WeActStudio/MiniSTM32H7xx/SDK/QSPI_Flasher/README.md

# QSPI Flasher

## STM32H7xx_W25Qxx_WeActStudio.FLM
> Keil MDK
Support 4MB ~ 16MB W25Qxx Flash

请将文件复制到 `Keil安装目录\ARM\Flash\`

Please copy the file to `"KeilInstallationDirectory"\ARM\Flash`

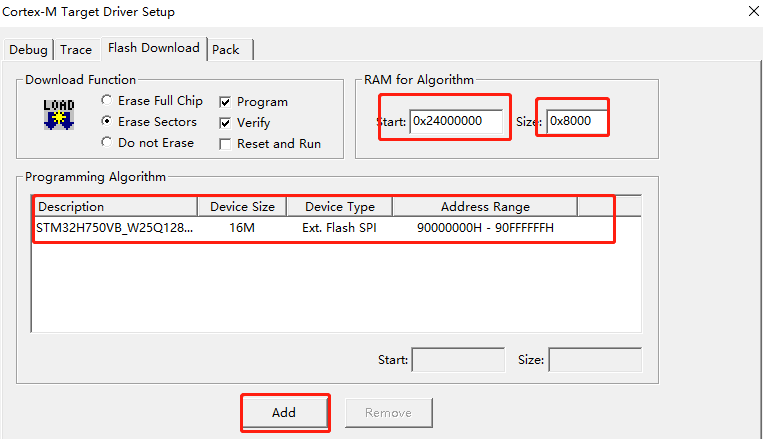
[picture p7: SDK/QSPI_Flasher/Images/KeilSetup.png]


## STM32H7xx_W25Qxx_WeActStudio.stldr
> STM32CubeProgrammer
Support 4MB ~ 16MB W25Qxx Flash

请将文件复制到 `STM32CubeProgrammer安装目录\bin\ExternalLoader\`

Please copy the file to `"STM32CubeProgrammerInstallationDirectory"\bin\ExternalLoader\`

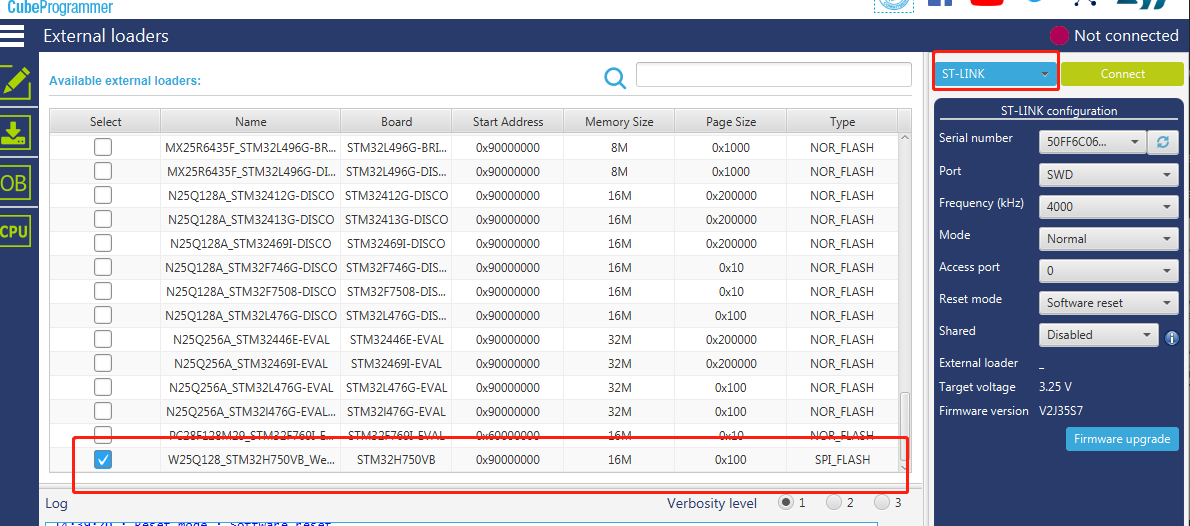
[picture p8: SDK/QSPI_Flasher/Images/STM32CubeProgSetup01.png]


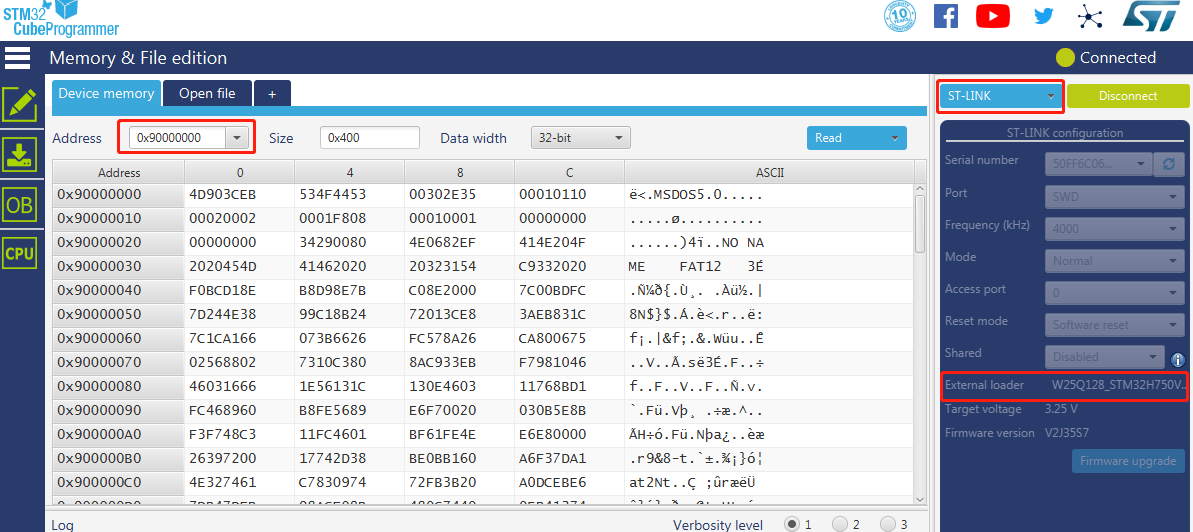
[picture p9: SDK/QSPI_Flasher/Images/STM32CubeProgSetup02.png]
