WeActStudio/MiniSTM32H7xx/SDK/HAL/STM32H743/05-DCMI_UVC/README.md

# WeAct Studio
## DCMI UVC Test

DCMI UVC测试，模拟USB摄像头，分辨率为160x120,帧率约为14FPS
* 支持OV2640,OV7670

DCMI UVC test, analog USB camera, 160x120 resolution, frame rate is about 14FPS
* Support for OV2640,OV7670
