WeActStudio/MiniSTM32H7xx/SDK/HAL/STM32H743/01-GPIO/README.md

# WeAct Studio
## GPIO Test

使用RNG随机数发生器生成随机数控制LED`PE3`随机闪烁

RNG random number generator is used to generate random Numbers to control LED `PE3` random flicker
