WeActStudio/MiniSTM32H7xx/SDK/openmv/Example/Below V4.4.1/track_color/README.md

# 使用说明

* [English](./README_EN.md)

当前例程为跟踪圆形的例程，可以使用下面的图片进行测试

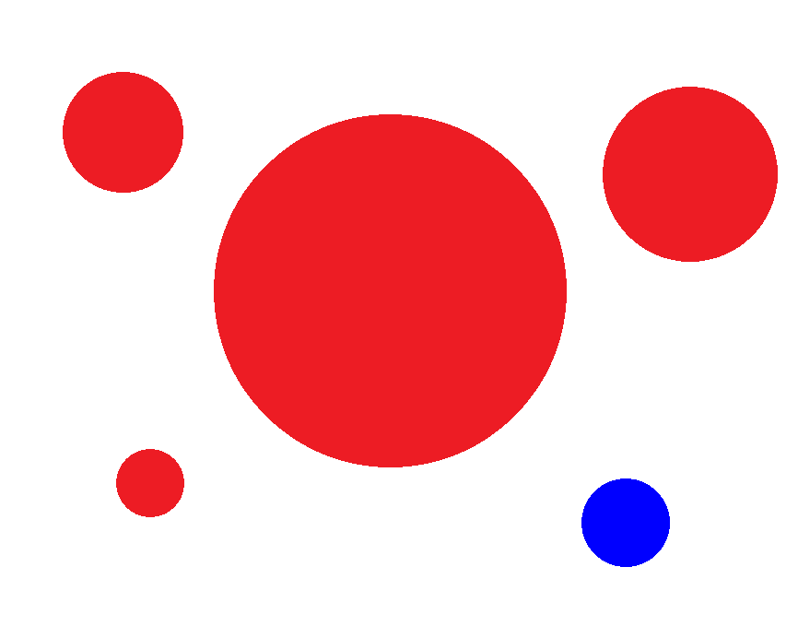
[picture p13: SDK/openmv/Example/Below V4.4.1/track_color/track_circle.png]
first


如果使用的是0v7725 请将下面两行代码反注释

``` c
sensor.set_hmirror(True)
sensor.set_vflip(True)
```

不同环境对应阈值也不同请根据你所在环境的阈值进行调整，也就是下面红绿蓝三个阈值

``` c
red_threshold = (53, 31, 44, 82, 18, 78)
```

对应IDE相应操作为：工具->机器视觉->阈值编辑器->帧缓冲区
