WeActStudio/MiniSTM32H7xx/SDK/HAL/STM32H743/02-ExtMem_Boot/README.md

# WeAct Studio
## ExtMem Boot

在8MB QSPI Flash上运行程序，该例程为QSPI Bootloader,APP Addr: `0x90000000`

Run the program on 8MB QSPI Flash, this routine is QSPI Bootloader,APP Addr: `0x90000000`
