WeActStudio/MiniSTM32H7xx/Images/Flash Delay.png

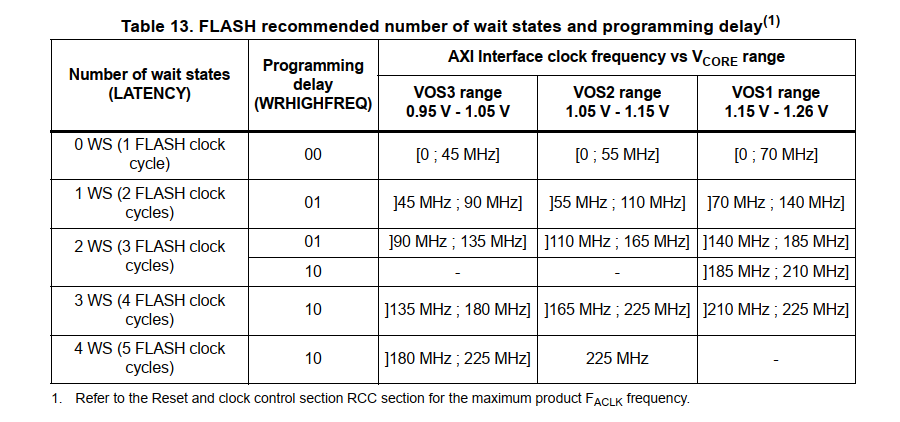
Images/Flash Delay.png
