WeActStudio/MiniSTM32H7xx/SDK/HAL/STM32H743/06-SPIFlash_Test/README.md

# WeAct Studio
## SPI Flash Test

两颗Flash读写测试，通过USB模拟成两个U盘

Two Flash read and write tests, through USB simulation into two U disk
