WeActStudio/MiniSTM32H7xx/SDK/HAL/STM32H743/07-ADC_Test/README.md

# WeAct Studio
## ADC Test

ADC 测试，通过ADC读取Vrefint,温度,vbat

ADC test, read Vrefint, temperature,vbat by ADC
