WeActStudio/MiniSTM32H7xx/SDK/HAL/STM32H743/09-PWR_Test/README.md

# WeAct Studio
## PWR Test

测试STANDBY模式下的电流，5V供电时，STANDBY模式，电流为0.9mA

The current in STANDBY mode was tested. When the power supply was 5V, the current in STANDBY mode was 0.9mA
