WeActStudio/MiniSTM32H7xx/SDK/HAL/STM32H743/03-LCD_Test/README.md

# WeAct Studio
## LCD Test

测试0.96寸ST7735液晶显示屏

Test the 0.96 inch ST7735 LCD Screen
