WeActStudio/MiniSTM32H7xx/SDK/HAL/STM32H743/04-SD_Test/README.md

# WeAct Studio
## Micro SD Test

TF卡读写测试，通过USB模拟成一个U盘

TF card read and write test, through USB simulation into a U disk
