WeActStudio/MiniSTM32H7xx/(threads)

Thread 1 (2020-07-21):

STM32H743?

koendv, 2020-07-21:
Do you also have this board with STM32H743?

ZYQ-FEIYUE, 2020-08-07:
Not yet, but the 750 can be used as a 743. The actual Flash of the 750 is 2MB, not 128KB

koendv, 2020-08-09:
That is interesting to know.

Closed 2020-08-09.

Thread 5 (2020-09-25):

Test projects compiled  with GCC doen't work properly

WiseLord, 2020-09-25:
I purchased the board and tried to compile the examples under GCC arm-none-eabi. I converted the following two projects into
"Makefile" project type via STM32CubeMX:
- SDK/HAL/03-LCD_Test/03-LCD_Test.ioc
- SDK/HAL/08-DCMI2LCD/08-DCMI2LCD.ioc

Than, I added missing Drivers/BSP/ST7735/*.c files into Makefile, as well as missing defines (TFT96) found in .uvprojx

My results:

- 03LCD_Test compiled with gcc-arm-none-eabi <= 7 works, while one compiled with gcc-arm-none-eabi >= 8 doesn't work. I can see brightness changing (so timer PWM is OK), but display initialization is failed whwn recent GCC is used.

- 08-DCMI2LCD has the same situation regarding LCD, while camera doesn't work in any case (it's detected, but nothing is shown on the screen even with "good" compiler).

So, the question: have the developers ever tried to build their examples in something different than Keil? It would be wonderful to have the examples really OS- and IDE-independent.

WeActTC, 2020-09-25:
1.The compiler overoptimizes 2.just going to step through and see what's wrong with the code 3.This is a bug in our code, need to optimize

WiseLord, 2020-09-25:
Actually, I also tried to disable optimization at all, with no effect. When I have some more free time, I'll try to look through it again.

On the other hand, you could also try recent GCC on your side.

WeActTC, 2020-09-25:
OK, If I have time, I will try!

WeActTC, 2020-09-25:
OK, If I have time, I will try!

Liuyufanlyf, 2021-03-08:
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

I believe [the newest pull request](https://github.com/WeActTC/MiniSTM32H7xx/pull/13) has solved this problem, you can have a try!

Closed 2022-07-24.

Thread 6 (2020-10-03):

Ports 在 OpenMV 3.6.8 版源码上编译不过

SuWeipeng, 2020-10-03:
刚刚尝试编译 `WeActStudioSTM32H7xx`，遇到两种错：

1、`omv_boardconfig.h`缺少宏定义，按其他配置加上不知道对不对：
```c
// Clock Sources
#define OMV_OSC_USB_CLKSOURCE       RCC_USBCLKSOURCE_PLL
#define OMV_OSC_ADC_CLKSOURCE       RCC_ADCCLKSOURCE_PLL3
#define OMV_OSC_SPI123_CLKSOURCE    RCC_SPI123CLKSOURCE_PLL3
```

2、这个不知道怎么解决
```
Use make V=1 or set BUILD_VERBOSE in your environment to increase build verbosity.
Warning: FROZEN_MPY_DIR is deprecated in favour of FROZEN_MANIFEST
CC usbd_cdc_interface.c
usbd_cdc_interface.c: In function 'usbd_cdc_receive':
usbd_cdc_interface.c:339:13: error: dereferencing type-punned pointer will break strict-aliasing rules [-Werror=strict-aliasing]
             cdc->dbg_xfer_length = *((uint32_t*)(cdc->rx_packet_buf+2));
             ^
cc1: all warnings being treated as errors
../../py/mkrules.mk:47: recipe for target '/github/openmv/openmv/src/build/micropython/usbd_cdc_interface.o' failed
make[1]: *** [/github/openmv/openmv/src/build/micropython/usbd_cdc_interface.o] Error 1
Makefile:600: recipe for target 'FIRMWARE_OBJS' failed
make: *** [FIRMWARE_OBJS] Error 2
```

SuWeipeng, 2020-10-04:
要用这个才行[https://github.com/WeActTC/openmv](https://github.com/WeActTC/openmv)

Closed 2020-10-04.

Thread 9 (2020-12-03):

HQQVGA actually 120x80

Kabron287, 2020-12-03:
In the documentation HQQVGA framesize declared as 160x80 but in fact it is 120x80.
See attached pictire.
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

WeActTC, 2020-12-03:
It could be an error in the OpenMV documentation

Kabron287, 2020-12-03:
I allready asked them about.

Closed 2022-07-24.

Thread 10 (2020-12-04):

What are the advantages of using QSPI Flash FW for OpenMV?

Kabron287, 2020-12-04:
I tryed both variants( **Internal Flash** and **QSPI Flash** ) and see no differences.

Kabron287, 2020-12-04:
Am I right that Flash Disk Size is larger?

WeActTC, 2020-12-04:
Flash Disk Size is the same, the difference is internal: the program runs in internal Flash, QSPI Flash: the program runs in external Flash

Kabron287, 2020-12-04:
I compared Flash Disks sizez in Weact board with QSPI OpenMV and original OpenMV H7 board. They are:
8 172 kB and 111 kB.
Does it means that in case of Weact board Flash Disk is created in SPI Flash?

WeActTC, 2020-12-04:
YES

Kabron287, 2020-12-04:
Thanks. I guess it has to be reflected in docs.

WeActTC, 2020-12-04:
Emmm, it doesn't matter

Kabron287, 2020-12-04:
To whom how

Closed 2022-07-24.

Thread 14 (2021-03-19):

"boot.py" not executing on boot.

erongd, 2021-03-19:
I have the STM32H750 board with OV7725 camera. I am using the v3.9.3 firmware.

Created boot.py to simply execute print('Hello World') as test. It does not get called. Upon boot the board executes main.py directly.

Closed 2022-07-24.

Thread 15 (2021-04-15):

ST7735 1.8inch LCD 驱动代码

Liuyufanlyf, 2021-04-15:
觉得 1.8inch LCD 的驱动代码真的有必要重构一下，现在是在 ST 的 ST7735 驱动上面包了一层 LCD 的封装，绘制点线多边形这些函数是 ST7735 层级的，显示字符串却是 LCD 层级的，亮度调整则两边都有，字符和字符串的显示也只限定了一种画笔色和背景色，初始化函数也没有包装出来。总之用户拿到手以后还要花很多力气去修改。个人建议要么就封装一个完整的 LCD 层，要么就拓展 ST7735 的驱动，LCD 层只用于配置。

anthroid, 2021-09-18:
I fully agree. Also, there is another ST7735 implementation that appears to address some of these problems [here](https://github.com/afiskon/stm32-st7735).

emalagonca, 2021-12-23:
The code is only an example to get started. It seems to be a bad idea to try to use the code in your project, the next piece of code was taken from the LDC_Light function, it contains some curious code like this temp2 = time_now - 0; there are more things to improve but this is only an example, so what's the problem?. I like this project for the hardware not for the software.

	temp1 = Brightness_Now;
	temp1 = temp1 - Brightness_Dis;
	temp2 = time_now;
	temp2 = temp2 - time;

	k = temp1 / temp2;

	uint32_t tick=get_tick();
	while(1)
	{
		delay_ms(1);
		time_now = get_tick()-tick;
		temp2 = time_now - 0;
		set = temp2*k + Brightness_Now;
		LCD_SetBrightness((uint32_t)set);
		if(time_now >= time) break;
	}

Closed 2022-07-24.

Thread 16 (2021-04-23):

Servo对象负角度无效

PuzzleKid, 2021-04-23:
import time
from pyb import Servo
s1 = Servo(1) # P7
s1.angle(-10)

WeActStudio, 2022-07-24:
阅读https://github.com/WeActStudio/MiniSTM32H7xx/issues/30

Closed 2022-07-24.

Thread 17 (2021-05-04):

How turn on internal drive

szybkijanek, 2021-05-04:
How turn on again internal drive because now device see only SD card? I burn on internal flash bootloader, firmware and openmv files and on QSPI 0x08000000 and 0x90000000 files but still i must insert SD card.

WeActStudio, 2022-07-24:
Flash the internal firmware.

Closed 2022-07-24.

Thread 18 (2021-05-27):

openmv source code problem

e135193, 2021-05-27:
Hello,

I have a compile error

```
boards/WeActStudioSTM32H7xx/bdev.c:5:8: error: unknown type name 'mp_spiflash_cache_t'
    5 | STATIC mp_spiflash_cache_t spi_bdev_cache;
      |        ^~~~~~~~~~~~~~~~~~~
boards/WeActStudioSTM32H7xx/bdev.c:11:6: error: 'const struct _mp_spiflash_config_t' has no member named 'cache'
   11 |     .cache = &spi_bdev_cache,
      |      ^~~~~
boards/WeActStudioSTM32H7xx/bdev.c:11:14: error: excess elements in struct initializer [-Werror]
   11 |     .cache = &spi_bdev_cache,
      |              ^
boards/WeActStudioSTM32H7xx/bdev.c:11:14: note: (near initialization for 'spiflash_config')
cc1: all warnings being treated as errors
make[1]: *** [../../py/mkrules.mk:77: /home/engin/openmv/src/build/micropython/boards/WeActStudioSTM32H7xx/bdev.o] Error 1
make[1]: *** Waiting for unfinished jobs....
make: *** [omv/ports/stm32/omv_portconfig.mk:591: FIRMWARE_OBJS] Error 2
```

Closed 2022-07-24.

Thread 19 (2021-06-23):

Pinout / Datasheet for peripherals

bakwc, 2021-06-23:
Hi! Thank you for your awesome board! I have a question about STM32H750 peripheral pinout. Do you have some documentation / pinout scheme or diagram? I'd like to know what are the LCD / Flash / Camera pins? Could you draw it / write it anywhere?

fivdi, 2021-06-23:
Perhaps you can find what is needed at https://github.com/WeActTC/MiniSTM32H7xx/tree/master/HDK

bakwc, 2021-06-23:
Thank you, found it here https://github.com/WeActTC/MiniSTM32H7xx/blob/master/HDK/STM32H7xx%20SchDoc%20V11.pdf

Closed 2021-06-23.

Thread 21 (2021-09-10):

LCD_Test program not working with STM32CubeIDE

fhervias, 2021-09-10:
The LCD_TEST compiles and runs fine. I see the blinking led but LCD remains blank. Using STM32CubeIDE.
I also called the LCD_Test function with same results. I traced the program and everything seems to run fine, I changed the color used with no luck.

Any idea how to solve this?

fhervias, 2021-09-10:
Nevermind, I got it working. I had placed the call to LCD_Test before the init routines were called. Fixed that and test program works now using STM32CubeIDE 1.7.0 under Ubuntu.

Closed 2021-09-10.

Thread 22 (2021-10-29):

installer_x64 STM32Bootloader

Givy, 2021-10-29:
Hi,
Cant get the driver installed on Windows 10.  Can't find the WeAct connection to Windows 10 device Manager;; WeAct_HID_Flash_NETFramework4+ V10 FluentWPF 191220 X64:

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

Which "Key" ? , I have three buttons on this board!
Many Thanks.

WeActStudio, 2022-07-24:
It meens K1 button

Closed 2022-07-24.

Thread 23 (2021-11-16):

LCD orientation

jongwoon-choi, 2021-11-16:
I want to use LCD as Landscape mode.

I found the "03-LCD_Test" project is set up as Portrait mode, it is not easy for me to change to Landscape mode.
Would you tell me how to change from Portrait to Landscape mode in "03-LCD_Test" project?

Best regards,
Jongwoon

WeActStudio, 2022-07-24:
You can read ST7735.c, and read an array of OrientationTab

jongwoon-choi, 2022-07-24:
p{margin-top:0;margin-bottom:0}

    Thanks for your answer.
--------- 원본 메일 ---------

        보낸사람: WeAct Studio ***@***.***>
        받는사람: WeActStudio/MiniSTM32H7xx ***@***.***>

            참조: Jongwoon Choi ***@***.***>, Author ***@***.***>

        날짜: 22.07.24 23:22 GMT +0900
        제목: Re: [WeActStudio/MiniSTM32H7xx] LCD orientation (Issue #23)

Closed #23 as completed.

—Reply to this email directly, view it on GitHub, or unsubscribe.You are receiving this because you authored the thread.Message ID: ***@***.***>

Closed 2022-07-24.

Thread 24 (2022-01-25):

Where to get replacement TFT

sukesh-ak, 2022-01-25:
I bought the H743 and didn't get the TFT in the package.

Where can I get a TFT with the exact same connector?
Any spec/name of the connector I can search for?

WeActStudio, 2022-07-24:
You can contact us through AliExpress.

Closed 2022-07-24.

Thread 25 (2022-02-03):

STM32H743 pinout

S0mbre, 2022-02-03:
Made a **colorful pinout** for the **STM32H743VIT board** using the official WeAct schemes and STM32 datasheet.

Please review and if OK, I will send updated version soon (with all AF's added to pins)
[STM32H7 Pin Layout.pdf](https://github.com/WeActTC/MiniSTM32H7xx/files/7992174/STM32H7.Pin.Layout.pdf)
[stm32h743 pinout.zip](https://github.com/WeActTC/MiniSTM32H7xx/files/7992176/stm32h743.pinout.zip)
.

ctag, 2023-05-27:
Hi, the files links lead to 404.

S0mbre, 2023-06-01:
Updated, please find attached here.
[STM32H7 Pin Layout.pdf](https://github.com/WeActStudio/MiniSTM32H7xx/files/11630198/STM32H7.Pin.Layout.pdf)
[stm32h743 pinout.zip](https://github.com/WeActStudio/MiniSTM32H7xx/files/11630199/stm32h743.pinout.zip)

skimans, 2025-03-28:
hi @S0mbre
there is update of pinout ?
thanks

Thread 26 (2022-02-25):

STM32H7xx QSPI FLM in keil?

acer1204, 2022-02-25:
My program is not enough to download this board.
I find this qspi setup, my keil is follow FLM setup.
and then i press download, but it show download failed...
my project code need to do something?

WeActStudio, 2022-07-24:
Look at the W25Qxx Target of our routine.

Closed 2022-07-24.

Thread 27 (2022-05-08):

Do your STM32H750 chips have working HASH and CRYP units?

Crest, 2022-05-08:
As confirmed by an STMicroelectronics employee in this [thread](https://community.st.com/s/question/0D53W000010RpinSAC/how-to-enable-the-stm32h750vbt6-hw-crypto) some STM32H750 chips have been shipped with fused off HASH and CRYP units resulting in 100% failure rate to write to any of their control and status registers. The date codes listed in [README.md](https://github.com/WeActTC/MiniSTM32H7xx/blob/master/README.md) for STM32H750 boards fall in the range of potentially defective chips.

Do your boards as offered on [AliExpress](https://www.aliexpress.com/item/1005001475058305.html) ship chips containing usable  HASH and CRYP units?

WeActStudio, 2022-07-24:
At present, the boards we produce are all the chips of batch 21 and later.

Closed 2022-07-24.

Thread 28 (2022-06-11):

Micropython Compile proble

e135193, 2022-06-11:
Hi, I got an compile error. What could be the solution ?

```
@ubuntu:~/openmv/src/micropython/ports/stm32$ make BOARD=WeActStudioSTM32H7xx
Use make V=1 or set BUILD_VERBOSE in your environment to increase build verbosity.
make: *** No rule to make target 'build-WeActStudioSTM32H7xx/modstm_qstr.h', needed by 'build-WeActStudioSTM32H7xx/genhdr/qstrdefs.generated.h'.  Stop.
```

Thread 29 (2022-07-03):

How to use "02-EXTMEM_BOOT" example?

ZergOfSwarm, 2022-07-03:
I am a beginner, and to me need memory-mapped mode, where the external memory is
seen as an internal memory... And I downloaded and flashed your  example "02-EXTMEM_BOOT" but, nothing has changed.

PS - I have a board of your production "WeActTC STM32H750VBT6" and I am sure many of your customers In the same situation as I.

WeActStudio, 2022-07-24:
You need to read the folder of SDK/QSPI_Flasher README, place the download algorithm in your Keil path.Then download and flash example "02-EXTMEM_BOOT, change routine(eg:03-LCD_Test) target to W25Qxx, download and flash it.

Closed 2022-07-24.

Thread 30 (2022-07-22):

OpenMV中Servo无法使用（Servo cannot be used in OpenMV）

linxizhixi, 2022-07-22:
# 环境
- 开发板：STM32H750
- OpenMV固件版本：4.3.0
- 舵机：SG90
# 问题描述
无法使用OpenMV的Servo
## 接线
棕色线->GND
红色线->5V
橙色线->D12
## Servo测试
### 代码
```python
import time
from pyb import Servo

s1 = Servo(1) # P7->(PD12)
s2 = Servo(2) # P8
while(True):
    for i in range(-90,90):
        s1.angle(i)
        s2.angle(i)
        time.sleep(10)
    for i in range(90,-90):
        s1.angle(i)
        s2.angle(i)
        time.sleep(10)
```
### 现象
舵机无任何反应
## PWM测试
### 代码
```python
from pyb import Pin, Timer

p = Pin('P7') # P7 has TIM4, CH1
tim = Timer(4, freq=1000)
ch = tim.channel(1, Timer.PWM, pin=p)
ch.pulse_width_percent(50)
```
### 现象
上电时转到固定角度

linxizhixi, 2022-07-24:
我把固件更新到最新(4.3.1)就可以使用了

Closed 2022-07-24.

Thread 31 (2022-07-25):

12-Thermopile-Shield Openmv examples does not works

Kabron287, 2022-07-25:
I used PB10 as SCL and PB11 as SDA signals for MLX90640
I see clock and data signals on scope at 50kHz when fir.init() executed, but then I got  error message:
**ValueError: Failed to detect a supported FIR sensor.**
These examples works fine with the original Openmv H7 board.

Kabron287, 2022-07-25:
1. It is definite bug in current FW. Look at the screenshot, MLX90640 address is found correctly, but then nothing happened.
2. There is no definition for **FIR_MLX90640** at all in FW.
Extended command **fir.init(type = fir.FIR_MLX90640)** allow to skip address searching, but in current FW version I got:
**AttributeError: 'module' object has no attribute 'FIR_MLX90640'** error

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
.

radiohound, 2023-01-31:
I am interested to find a solution for this as well. Thanks Kabron287 for your trouble shooting.

Thread 32 (2022-11-17):

希望能编写一个openocd初始化QSPI FLASH的脚本

liyang5945, 2022-11-17:
买的H750板子，尝试使用gcc工具链+vscode开发stm32，无奈发现无法使用openocd将程序下到这块板子的外置FLASH里，在网上找到一篇教程：[使用openOCD擦写ART_Pi外部qspi_flash](https://club.rt-thread.org/ask/article/95a03d2494e01ada.html) ，我尝试了之后没有成功，也不知道该怎么改，希望能编写一个openocd初始化QSPI FLASH的脚本。

上面帖子里的 gpio_conf_stm32.pl是:https://github.com/openocd-org/openocd/blob/36597636f2a0e9fbf7b44f2c02fb85632d4dc063/contrib/loaders/flash/stmqspi/gpio_conf_stm32.pl 运行需要安装perl环境，在控制台执行 perl gpio_conf_stm32.pl

帖子里的art_pi.cfg内容
```
# This is for using the onboard STLINK
source [find interface/stlink.cfg]

transport select hla_swd

set CHIPNAME stm32h750xbh6

# enable stmqspi
if {![info exists QUADSPI]} {
    set QUADSPI 1
}

source [find target/stm32h7x.cfg]

reset_config srst_only

# ART_Pi qspi.

# QUADSPI initialization
proc qspi_init {  } {
    global a
    mmw 0x580244E0 0x000007FF 0             ;# RCC_AHB4ENR |= GPIOAEN-GPIOKEN (enable clocks)
    mmw 0x580244D4 0x00004000 0             ;# RCC_AHB3ENR |= QSPIEN (enable clock)
    sleep 1                                 ;# Wait for clock startup

    # PF10:AF09:H, PF09:AF10:H, PF08:AF10:H, PF07:AF09:H, PF06:AF09:H, PG06:AF10:H

    # Port F: PF10:AF09:H, PF09:AF10:H, PF08:AF10:H, PF07:AF09:H, PF06:AF09:H
    mmw 0x58021400 0x002AA000 0x00155000    ;# MODER
    mmw 0x58021408 0x002AA000 0x00155000    ;# OSPEEDR
    mmw 0x5802140C 0x00000000 0x003FF000    ;# PUPDR
    mmw 0x58021420 0x99000000 0x66000000    ;# AFRL
    mmw 0x58021424 0x000009AA 0x00000655    ;# AFRH
    # Port G: PG06:AF10:H
    mmw 0x58021800 0x00002000 0x00001000    ;# MODER
    mmw 0x58021808 0x00002000 0x00001000    ;# OSPEEDR
    mmw 0x5802180C 0x00000000 0x00003000    ;# PUPDR
    mmw 0x58021820 0x0A000000 0x05000000    ;# AFRL

    # correct FSIZE is 0x16, however, this causes trouble when
    # reading the last bytes at end of bank in *memory mapped* mode

    # for single flash mode w25q64jv
                                            ;# 010101010000000000000 0 011000
    mww 0x52005000 0x05500018               ;# QUADSPI_CR: PRESCALER=5, APMS=1, FTHRES=1, FSEL=0, DFM=0, SSHIFT=1, TCEN=1
    mww 0x52005004 0x00160500               ;# QUADSPI_DCR: FSIZE=0x16, CSHT=0x05, CKMODE=0
                                            ;# FSIZE flash的大小。

    mww 0x52005030 0x00001000               ;# QUADSPI_LPTR: deactivate CS after 4096 clocks when FIFO is full
                                            ;# 11010000000000 10 010100000011
    mww 0x52005014 0x0D002503               ;# QUADSPI_CCR: FMODE=0x3, DMODE=0x1, DCYC=0x0, ADSIZE=0x2, ADMODE=0x1, IMODE=0x1
    mmw 0x52005000 0x00000001 0             ;# QUADSPI_CR: EN=1

    # Exit QPI mode
    #mmw 0x52005000 0x00000002 0            ;# QUADSPI_CR: ABORT=1
    #mww 0x52005014 0x000003F5              ;# QUADSPI_CCR: FMODE=0x0, DMODE=0x0, DCYC=0x0, ADSIZE=0x0, ADMODE=0x0, IMODE=0x3, INSTR=Exit QPI
    sleep 1

    # reset flash
    mmw 0x52005000 0x00000002 0             ;# QUADSPI_CR: ABORT=1
    mww 0x52005014 0x00000166               ;# QUADSPI_CCR: FMODE=0x0, DMODE=0x0, DCYC=0x0, ADSIZE=0x0, ADMODE=0x0, IMODE=0x1, INSTR=0x66
    mww 0x52005014 0x00000199               ;# QUADSPI_CCR: FMODE=0x0, DMODE=0x0, DCYC=0x0, ADSIZE=0x0, ADMODE=0x0, IMODE=0x1, INSTR=0x99

    # memory-mapped read mode with 3-byte addresses
    mmw 0x52005000 0x00000002 0             ;# QUADSPI_CR: ABORT=1
                                            ;# 11 11 0 00100 00 11 10 11 01 11101011
    mww 0x52005014 0x0F10EDEB               ;# QUADSPI_CCR: FMODE=0x3, DMODE=0x3, DCYC=0x4, ADSIZE=0x2, ADMODE=0x3, IMODE=0x1, INSTR=READ
    ;mww 0x52005014 0x0D002503
}

$_CHIPNAME.cpu0 configure -event reset-init {
    global QUADSPI

    mmw 0x52002000 0x00000004 0x0000000B    ;# FLASH_ACR: 4 WS for 192 MHZ HCLK

    mmw 0x58024400 0x00000001 0x00000018    ;# RCC_CR: HSIDIV=1, HSI on
    mmw 0x58024410 0x10000000 0xEE000007    ;# RCC_CFGR: MCO2=system, MCO2PRE=8, HSI as system clock
    mww 0x58024418 0x00000040               ;# RCC_D1CFGR: D1CPRE=1, D1PPRE=2, HPRE=1
    mww 0x5802441C 0x00000440               ;# RCC_D2CFGR: D2PPRE2=2, D2PPRE1=2
    mww 0x58024420 0x00000040               ;# RCC_D3CFGR: D3PPRE=2
    mww 0x58024428 0x00000040               ;# RCC_PPLCKSELR: DIVM3=0, DIVM2=0, DIVM1=4, PLLSRC=HSI
    mmw 0x5802442C 0x0001000C 0x00000002    ;# RCC_PLLCFGR: PLL1RGE=8MHz to 16MHz, PLL1VCOSEL=wide
    mww 0x58024430 0x01070217               ;# RCC_PLL1DIVR: 192 MHz: DIVR1=2, DIVQ=8, DIVP1=2, DIVN1=24
    mmw 0x58024400 0x01000000 0             ;# RCC_CR: PLL1ON=1
    sleep 1
    mmw 0x58024410 0x00000003 0             ;# RCC_CFGR: PLL1 as system clock
    sleep 1

    adapter speed 24000

    if { $QUADSPI } {
        qspi_init
    }
}

```

Closed 2022-11-23.

Thread 35 (2023-05-27):

Is the board layout available?

ctag, 2023-05-27:
Hi,

I see that there is a schematic available, but is there a board layout as well to map components from the schematic to the PCB?

WeActStudio, 2023-05-28:
Sorry this not provide

Thread 36 (2023-06-05):

Please publish the full .ioc file of the STM32H750VBTx board.

zapta, 2023-06-05:
Hello, when I load the sample .ioc from here in Cube IDE, the MCU is configured as 240Mhz instead of 480Mhz (see attached image).   It seems that DIVP1 in your file has an invalid value of 1 while the Cube IDE requires it to be at least 2.

Please publish a full .ioc file with all the peripherals and and full clock speed so we can use it for our projects.

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

Thread 37 (2023-06-09):

The LCD didn't work when I complied OpenMV board WeActStudioSTM32H7xx

VisionShilin, 2023-06-09:
The LCD didn't work when I complied OpenMV board WeActStudioSTM32H7xx.

gelan77, 2023-06-28:
Hi But maybe I won't help with your problem but if it's not difficult for you to which pins the display is connected to? I searched but I didn't understand through spi or through LTDC?

Thread 38 (2023-07-20):

I couldnt work MiniSTM32H7xx/SDK/HAL/STM32H743 /07-ADC_Test/ example on cubeide 1.13

muratgunay0, 2023-07-20:
This example can work when i complie it on keil 5 complier version 5. But when i import it to cubeide over ioc file. i just take static noise on screen and nothing happening. I think this is spi related problem or clock settings but i dont know what i miss. During import to cubeide i have tried migration and old version of ioc file setting. Both is the same result.
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

nspsck, 2023-07-30:
Hi, I am not familiar with STM32, nor with this board, but I have dealt with some TFT and OLED displays. This looks like a display initialization problem to me. Are you sure that you set the hardware reset pin correctly? Have you tried pull down for reset? Since your display did indeed work, and the display noise is static, I personally do not think that there are any problem with the clock or SPI. If the problem are caused by the clock or SPI, you will not see a static noise, unless your are just displaying a constant frame.

Related post: [https://github.com/orgs/micropython/discussions/10820](https://github.com/orgs/micropython/discussions/10820)

Thread 40 (2023-08-10):

stm32h750 qspi boot

blcouz, 2023-08-10:
Can anyone run apps on Qspi?
https://github.com/blcouz/STM32H750-QSPI-Boot.git

blcouz, 2023-08-11:
I think the problem is in the qspi application that will run after boot. I followed this video (https://www.youtube.com/watch?v=gAyuF20ok8c).(Memory mapped mod works fine)

Closed 2023-08-23.

Thread 42 (2023-11-07):

OpenMV setup help

Guilherme-Mello, 2023-11-07:
Hello, i just got my dev board. But i'm having difficulties to run openMV on it, i followed the tutorial in the sdk/openmv part of this git, but couldn't get this to work. Is there any specific procedure? is there any tutorial video showing how to do this?

hope someone can help me.

WeActStudio, 2023-11-09:
Hello, you can download openmv.bin via stm32cubepro through usb(typec cable). Follow this link: https://github.com/WeActStudio/MiniSTM32H7xx/blob/master/SDK/openmv/Firmwares/V4.4.1/Internal%20Flash/openmv.bin

Thread 43 (2023-11-10):

Can I get information about the use of PINs?

rizacelik, 2023-11-10:
31 PINs are reserved for hardware such as camera, LCD screen, MicroSD, SOUND. There are very few PINs left.
Can 31 PINs be used for other things? So, if not all, at least some of them can be used? If it is not used, why did you give it on the board?.
I use your boards for Flight Controller and share the Firmware and installations. I would like to use this motherboard, but I wanted to ask because it has very few PINs.

synersignart, 2024-02-15:
so far I have few info on it , the micro sd card uses the SDIO making SPI3 unusable , one of the  SPI1 is occupied by the Flash but I have no idea how to make it work and the LCD is sitting on SPI4 so this is unusable .  so the only usable is SPI2 for the IMU how ever I2C 1 and 2 are free

rizacelik, 2024-02-21:
Thank you for your response. I gave up on the WeAct Studio H743 card. I ordered the devEBOX H743 board instead. I'll work on it when it arrives.

rizacelik, 2024-02-21:
I waited for an answer for a long time, but it was not answered. That's why I gave up.  Thank you.

lorenzoridolfi, 2024-10-20:
I won't buy this board anymore due lack of basic support.

Thread 44 (2023-12-27):

STM32H723 soft example

Jalal82, 2023-12-27:
Hello Can you please add STM32H723 soft example using hal lib, the repo contain only  resources for STM32H743 STM32H750 boards

ZYQ-FEIYUE, 2023-12-28:
https://github.com/WeActStudio/WeActStudio.MiniSTM32H723

Thread 46 (2024-04-06):

TFT display

Nobbyhexer, 2024-04-06:
Which library do I need for the TFT display in the Arduino IDE?
#include <Adafruit_GFX.h>
#include <Adafruit_ST7735.h>
#include <SPI.h>
#define TFT_CS         PE11
#define TFT_RST        -1
#define TFT_DC         PE13
Adafruit_ST7735 tft = Adafruit_ST7735(TFT_CS, TFT_DC, TFT_RST);

Unfortunately, this does not work.

Closed 2024-04-07.

Thread 47 (2024-05-02):

HEY CAN I GET the schematic files for this

Mkayktk, 2024-05-02:

Mkayktk, 2024-05-02:
i need Altium design file is there any design file for stm32h7 board'

WeActStudio, 2024-05-04:
https://github.com/WeActStudio/MiniSTM32H7xx/blob/master/HDK/STM32H7xx%20CoreBoard%20AltiumDesigner.IntLib

At 2024-05-03 06:23:35, "Mkayktk" ***@***.***> wrote:

i need Altium design file is there any design file for stm32h7 board'

—
Reply to this email directly, view it on GitHub, or unsubscribe.
You are receiving this because you are subscribed to this thread.Message ID: ***@***.***>

Thread 49 (2024-07-19):

New board definitions for OpenMV v4.4.1 or v4.5.5

sashaegorov, 2024-07-19:
Hi, **Dear WeActStudio Team**!

First of all, thank you so much for great products! I'm happy owner of two WeAct STM32 H743 boards, Mini STLink, USB to TTL converter, CH9143 BLE to USB2UART, WeAct ESP32 few others products. They are absolutely awesome!👍🏻 I'm big fan how well these board built and designed.

I think this great board, and STM32H742 is promising MCU, it will be my to-go board for long time. However, I think maintenance of SDK could be improved, along with the documentation. I can help with testing, building or writing examples which is very helpful for new users, who don't know C/C++ language; or contribute something to this project.

Regarding WeAct H743 board I'm mostly aimed on it's OpenMV and MicroPython (not checked yet) capabilities. Currently I'm trying to build the latest version of OpenMV (which is [v4.5.5](https://github.com/openmv/openmv/tree/v4.5.5)) and it's failing. It has a lot of compiler warnings and errors with no quick fix.

If you have definitions you used to compile [SDK/openmv/Firmwares/V4.4.1](https://github.com/WeActStudio/MiniSTM32H7xx/tree/master/SDK/openmv/Firmwares/V4.4.1) firmware, can you push to this repo? I'll try to compile them with v4.5.5

I've checked the following:
- [SDK/openmv/Firmwares/V4.4.1](https://github.com/WeActStudio/MiniSTM32H7xx/tree/master/SDK/openmv/Firmwares/V4.4.1) - updated one year ago or so, however it works well with the board👍🏻
- Board definitions
  - [SDK/openmv/Ports/omv/boards/WeActStudioSTM32H7xx](https://github.com/WeActStudio/MiniSTM32H7xx/tree/master/SDK/openmv/Ports/omv/boards/WeActStudioSTM32H7xx) I've tried to compile with this board definition, it for [openmv firmware to v3.9.3](https://github.com/WeActStudio/MiniSTM32H7xx/commit/5998d6307fe56e66c1dd2178a1d292eb68e86692) only
  - [SDK/openmv/Ports/micropython/boards/WeActStudioSTM32H7xx](https://github.com/WeActStudio/MiniSTM32H7xx/tree/master/SDK/openmv/Ports/micropython/boards/WeActStudioSTM32H7xx) same story here
- WeActStudio Repos
  - [WeActStudio/openmv](https://github.com/WeActStudio/openmv) repo, looks like it was updated long time ago
  - [WeActStudio/micropython](https://github.com/WeActStudio/micropython) same, updated long time ago

sashaegorov, 2024-10-23:
@WeActStudio please🙏

WeActStudio, 2024-10-24:
Need in this branches.

---- Replied Message ----
| From | Alexander ***@***.***> |
| Date | 10/24/2024 04:07 |
| To | ***@***.***> |
| Cc | WeAct ***@***.***>***@***.***> |
| Subject | Re: [WeActStudio/MiniSTM32H7xx] New board definitions for OpenMV v4.4.1 or v4.5.5 (Issue #49) |

@WeActStudio please🙏

—
Reply to this email directly, view it on GitHub, or unsubscribe.
You are receiving this because you were mentioned.Message ID: ***@***.***>

Thread 55 (2025-07-04):

USB - Serial

imabot2, 2025-07-04:
I can't figure out how to use the USB as Serial port for logging debug strings in a terminal. According to the schematics, the USB D- and D+ pins are connected to PA11 and PA12. On the main page of this repo, it's written :

> Serial Port Mode: Connect PA9 and PA10 of core board with USB serial port

PA9 and PA10 are just connected to the I/O pin headers. There is something unclear about how to use the USB port.
