WeActStudio/MiniSTM32H7xx/Hardware/OV7725-M12-Camera SchDoc.pdf

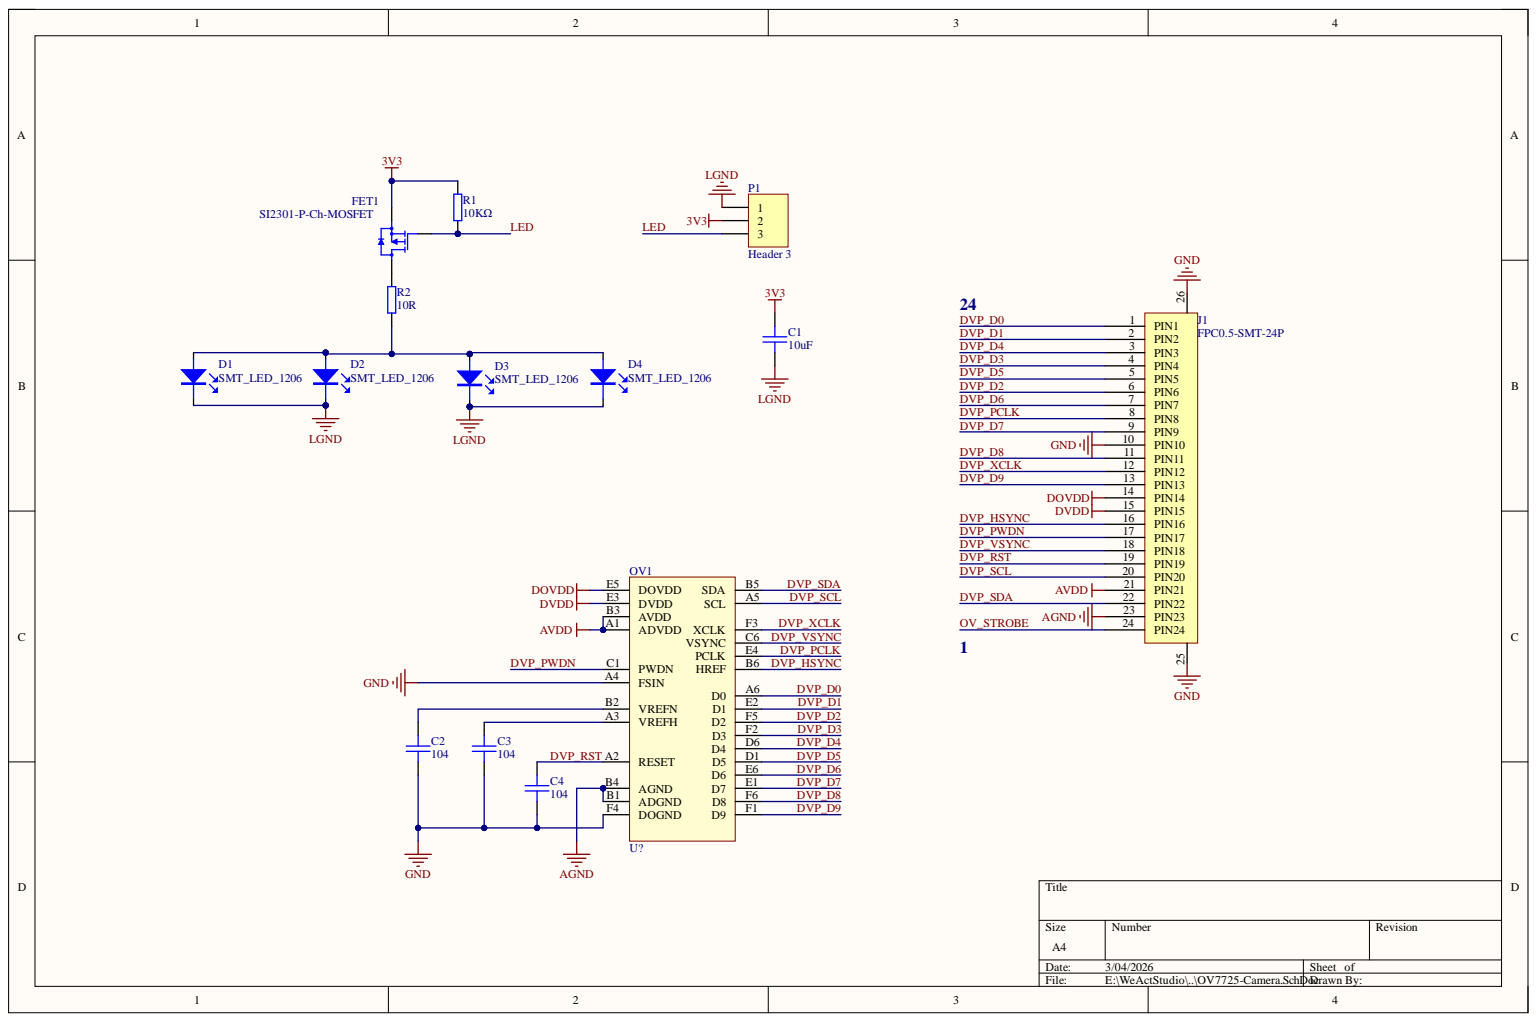
[picture p15: page 1]
