WeActStudio/MiniSTM32H7xx/Hardware/OV7725-Camera Board Shape 外形.pdf

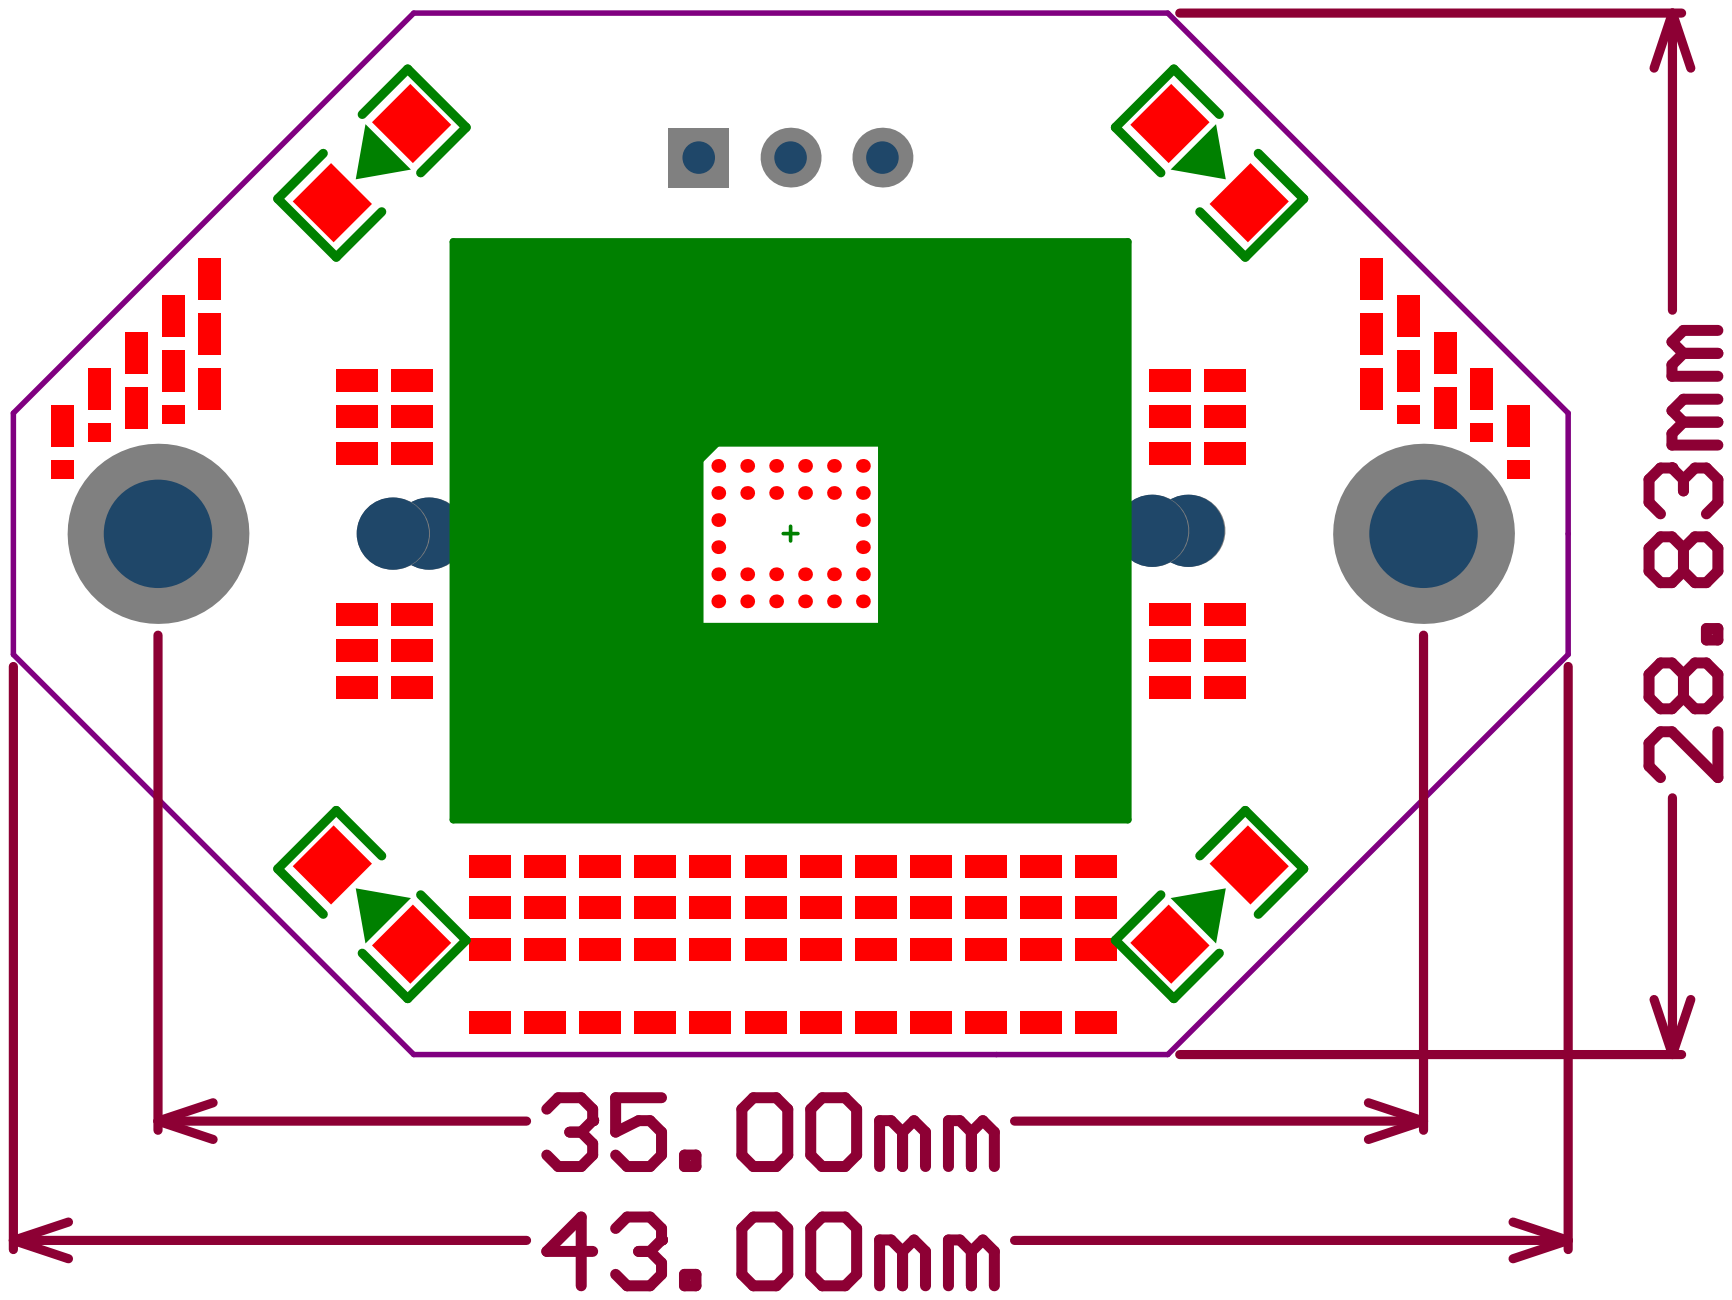
[picture p16: page 1]

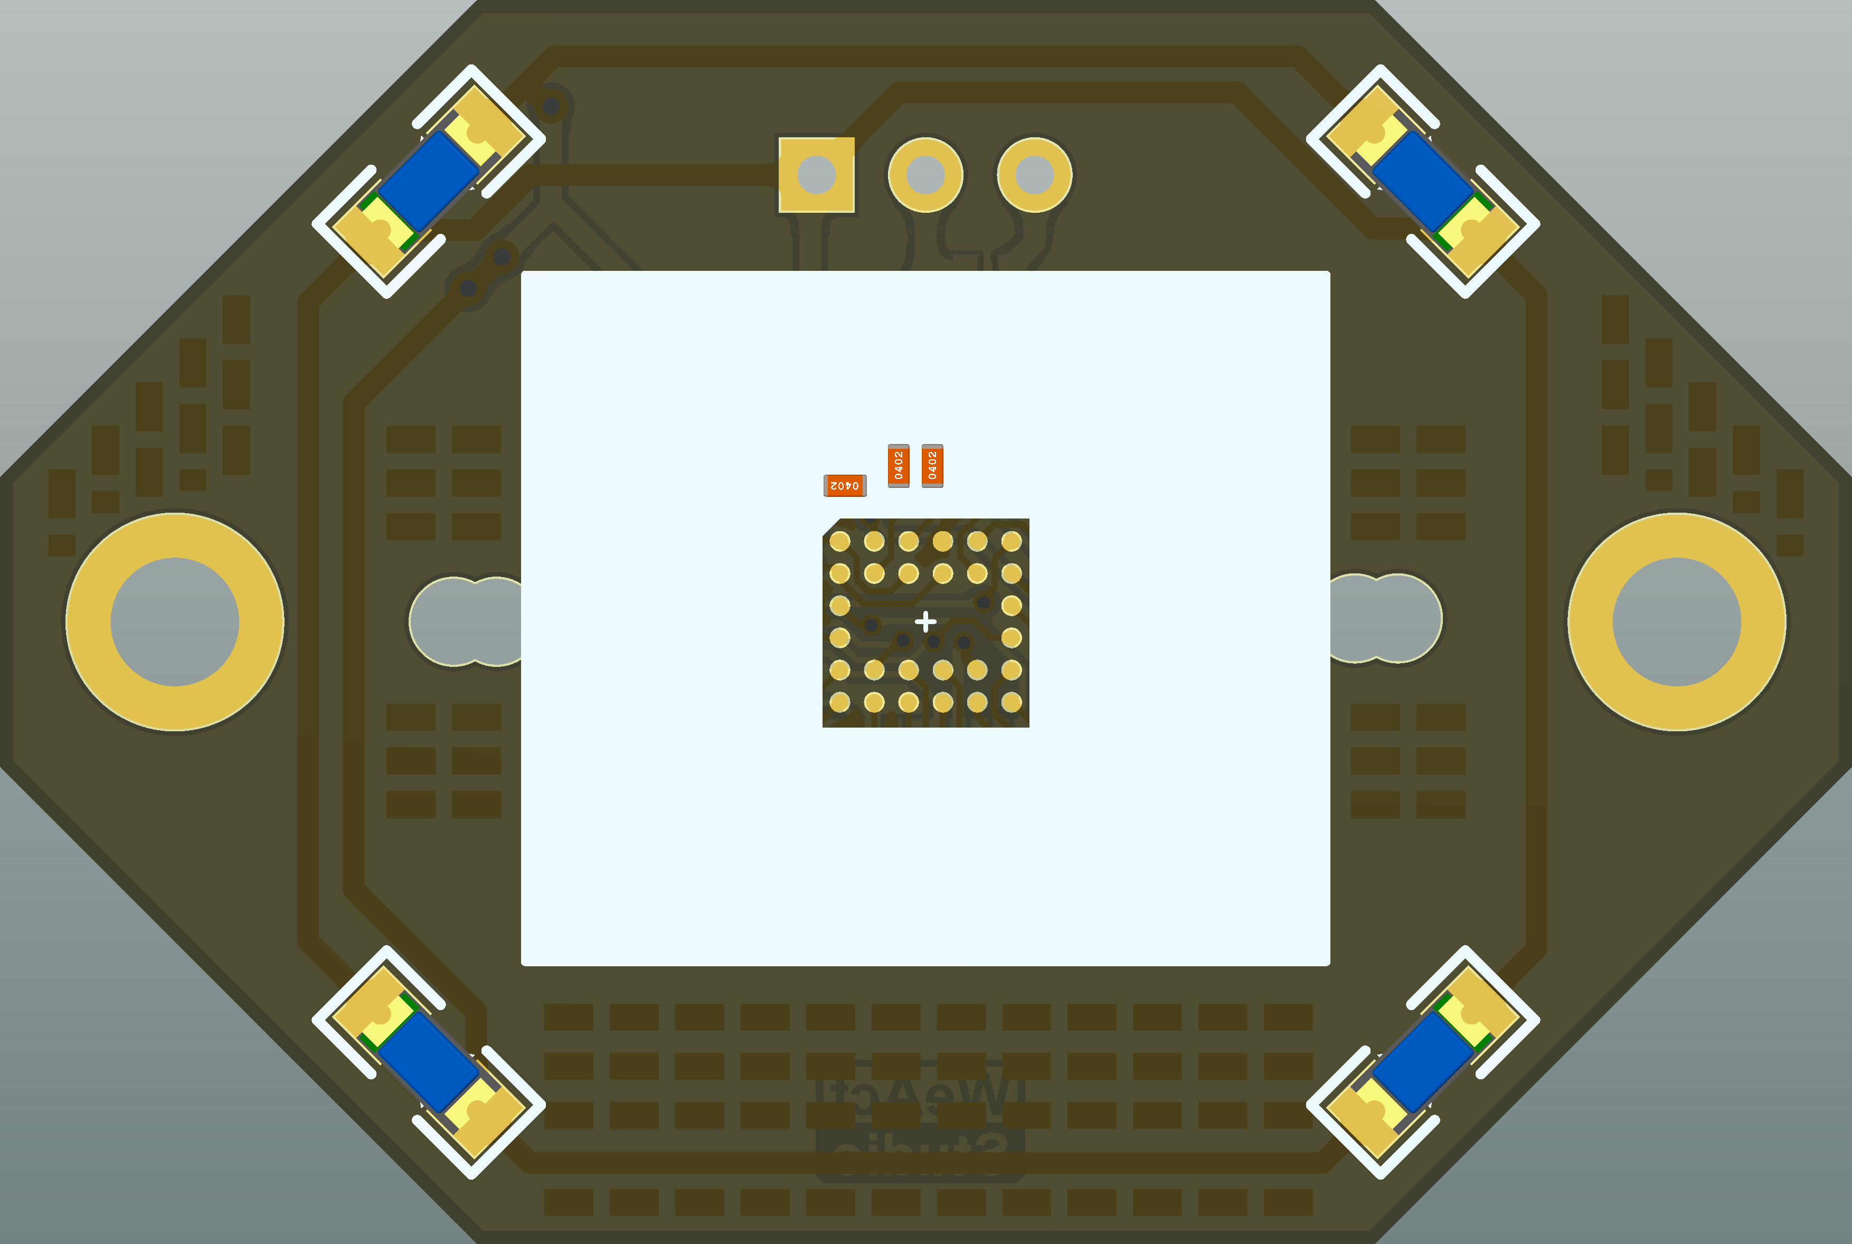
[picture p17: page 2]

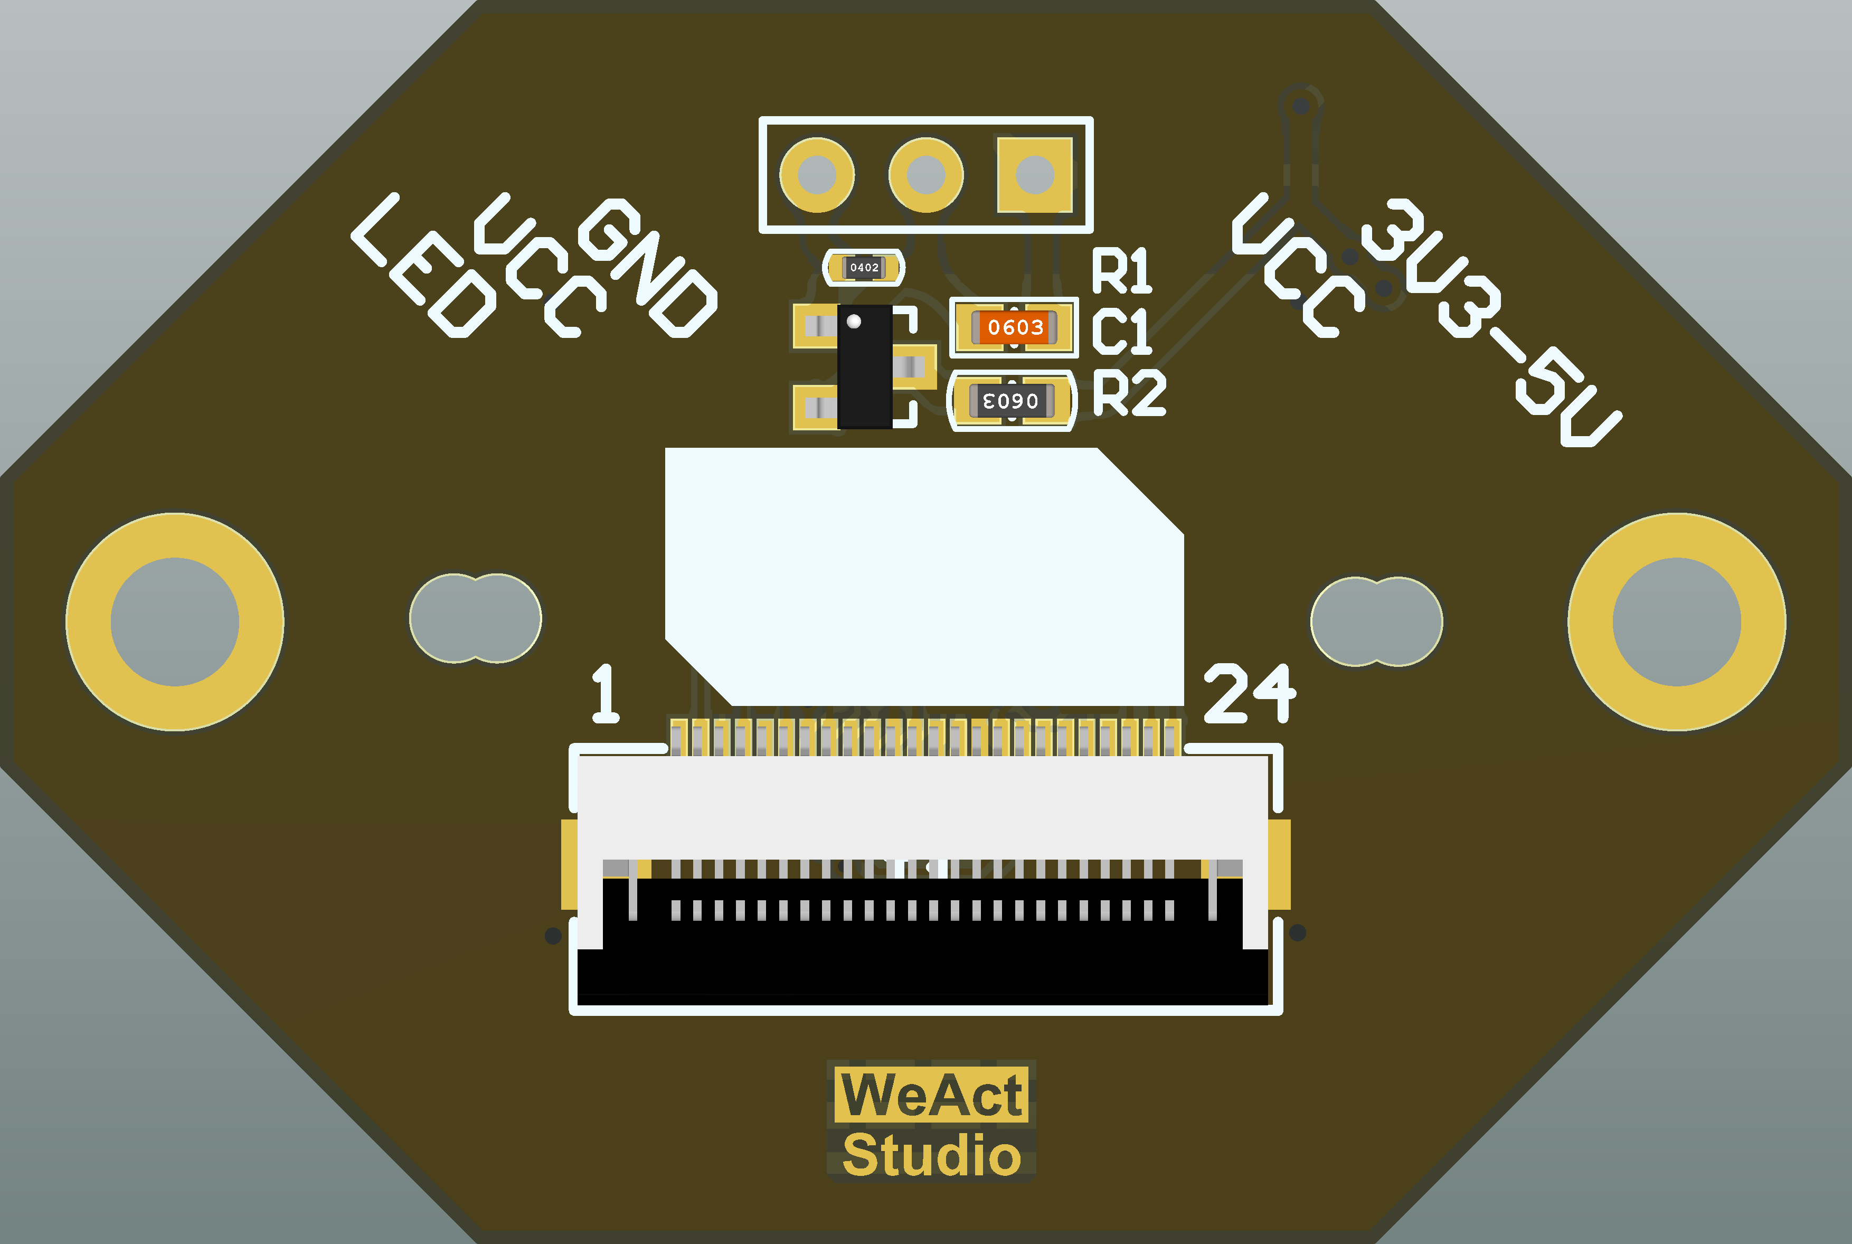
[picture p18: page 3]
