WeActStudio/MiniSTM32H7xx/Hardware/STM32H7xx SchDoc V12.pdf

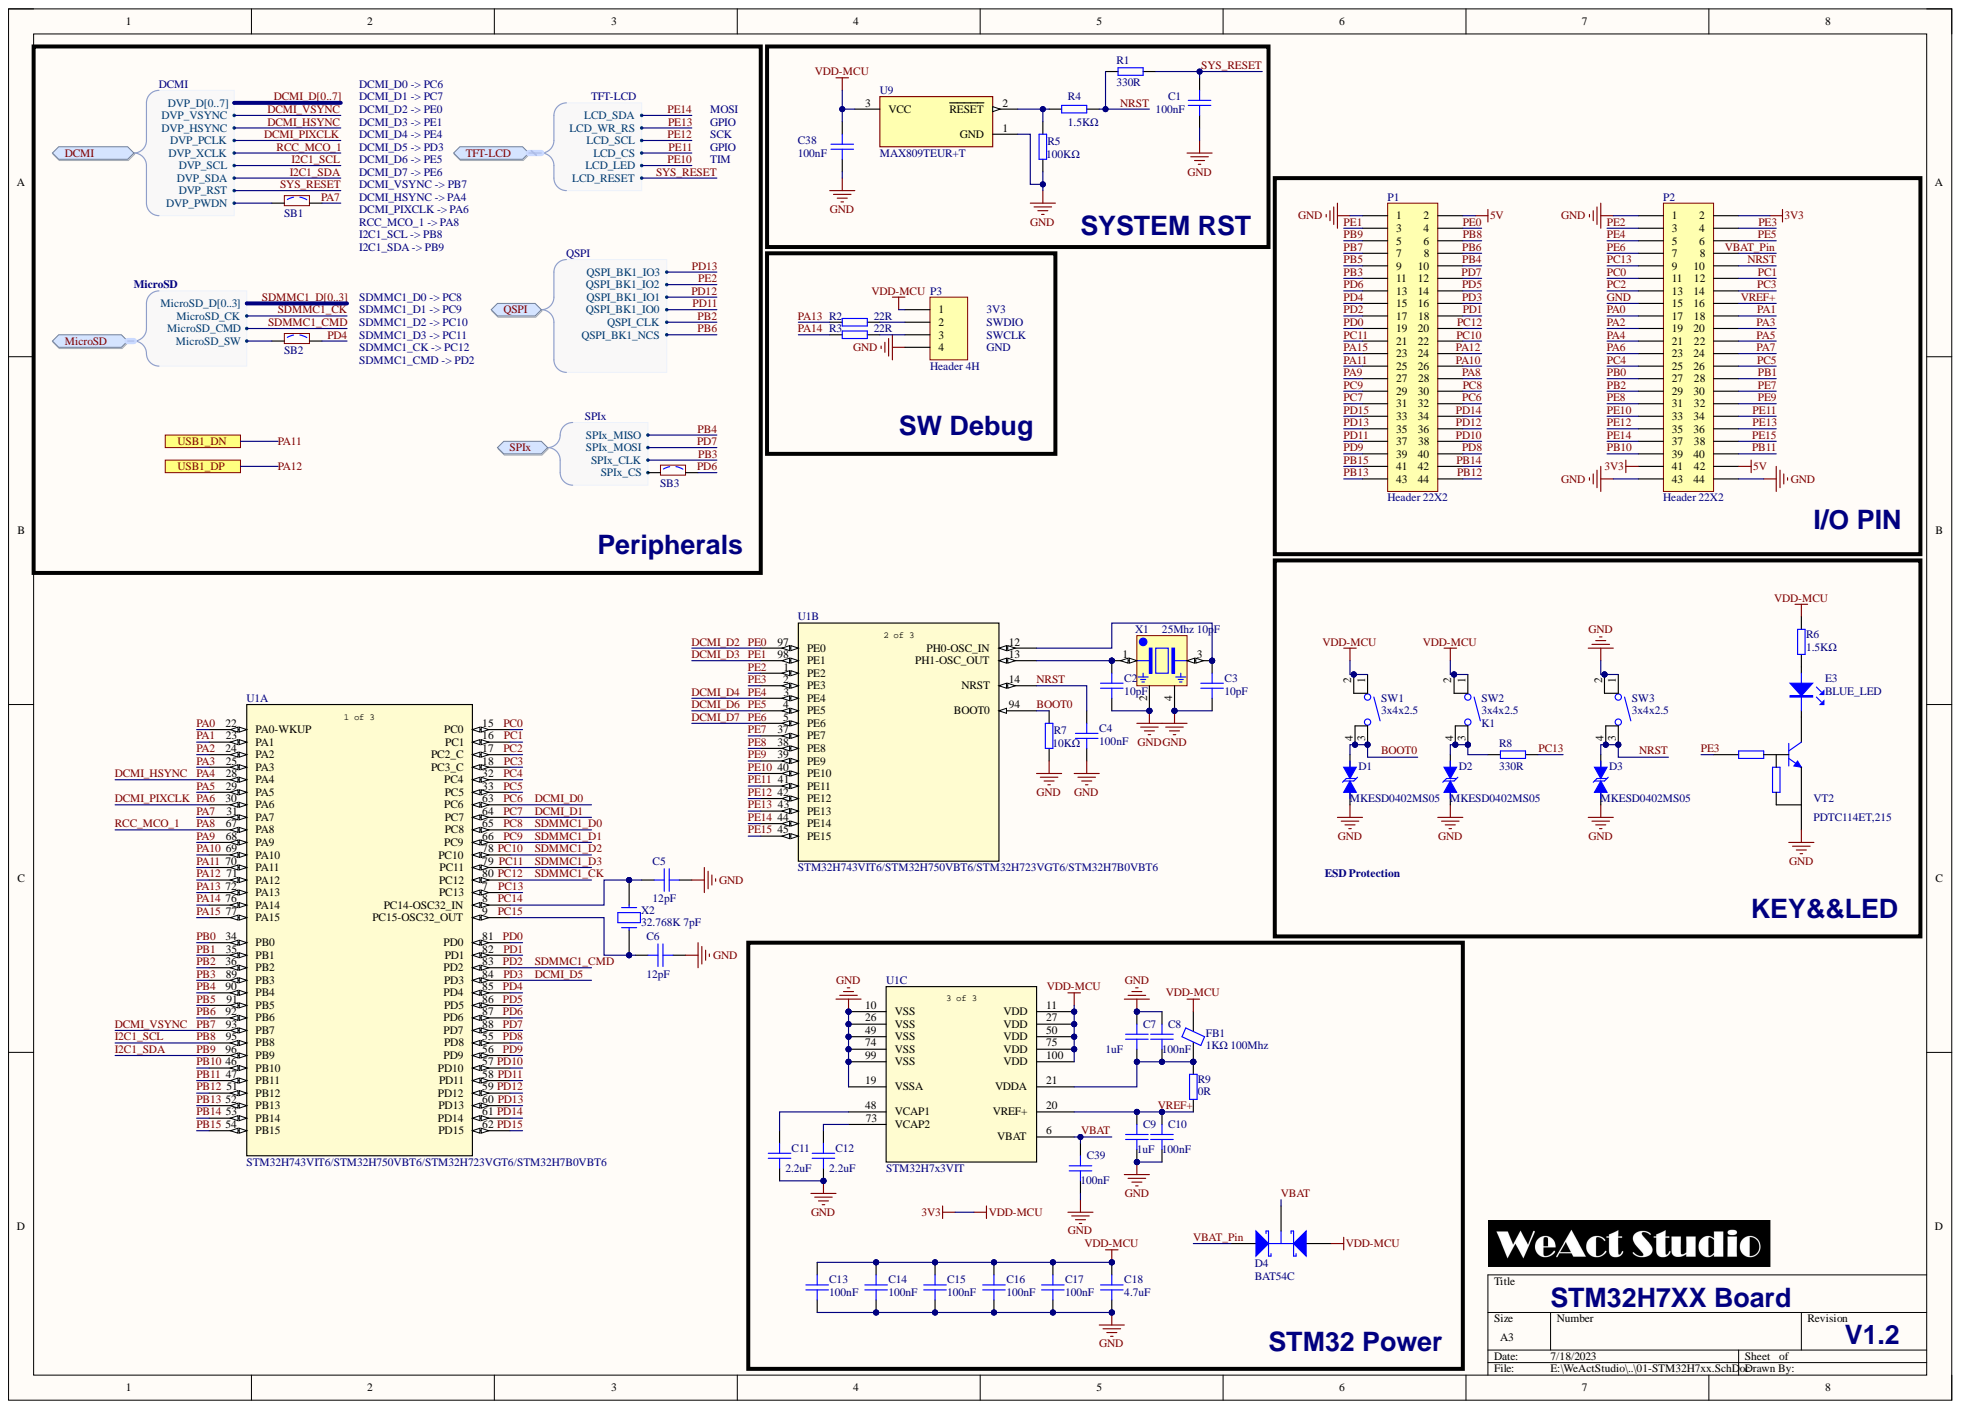
[picture p19: page 1]

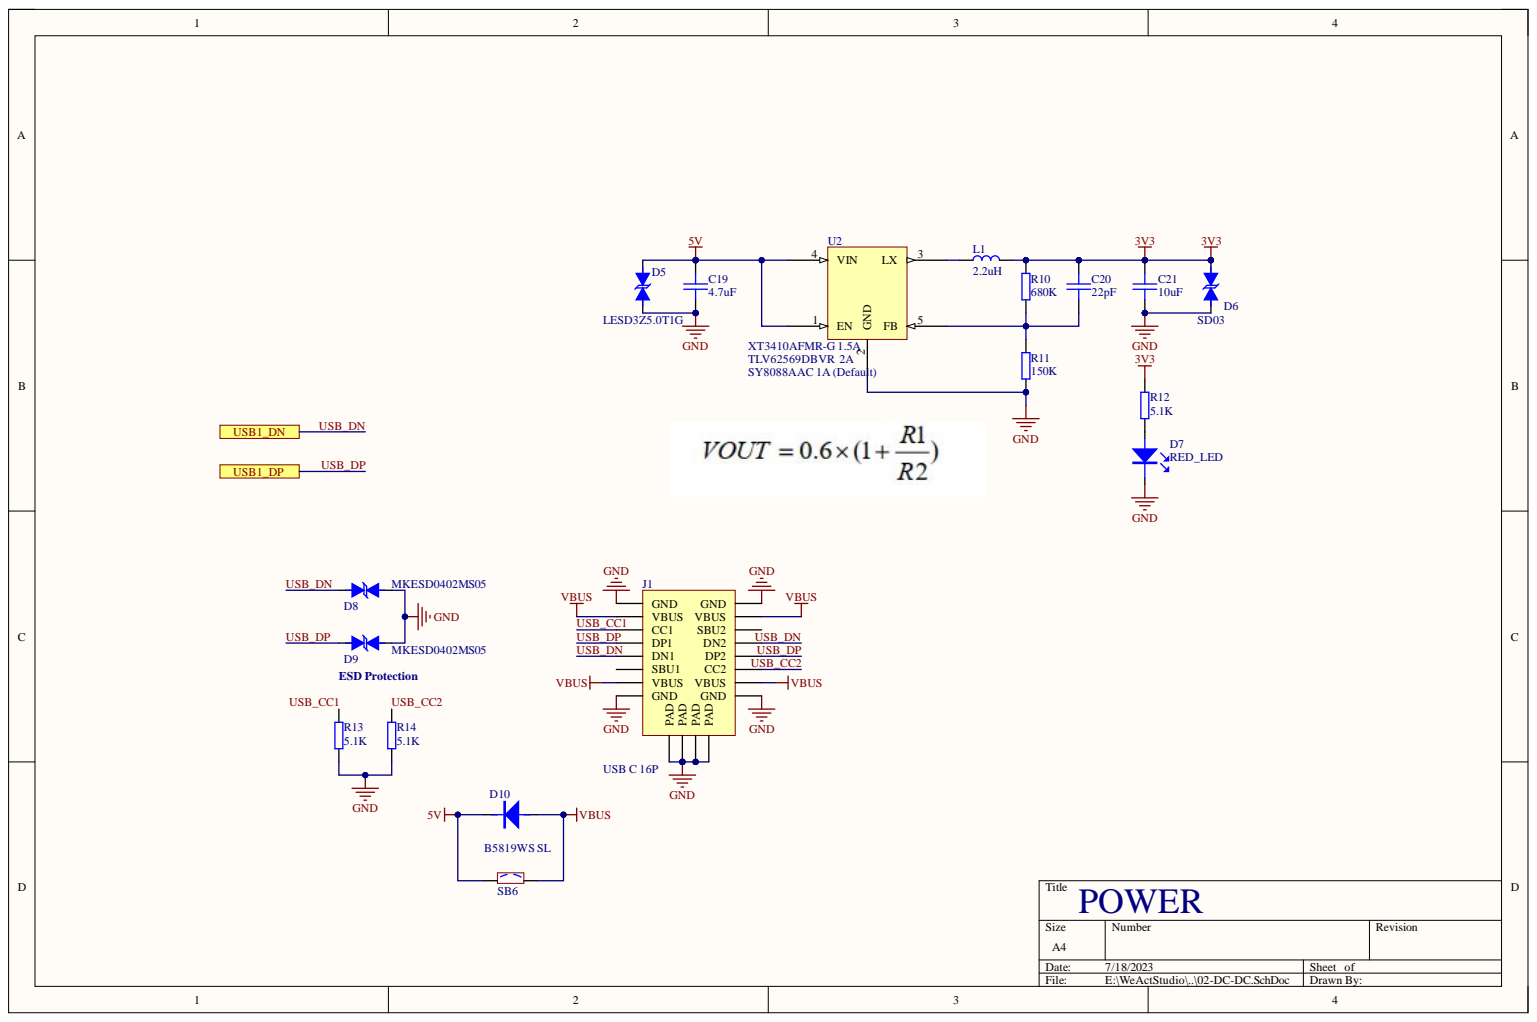
[picture p20: page 2]

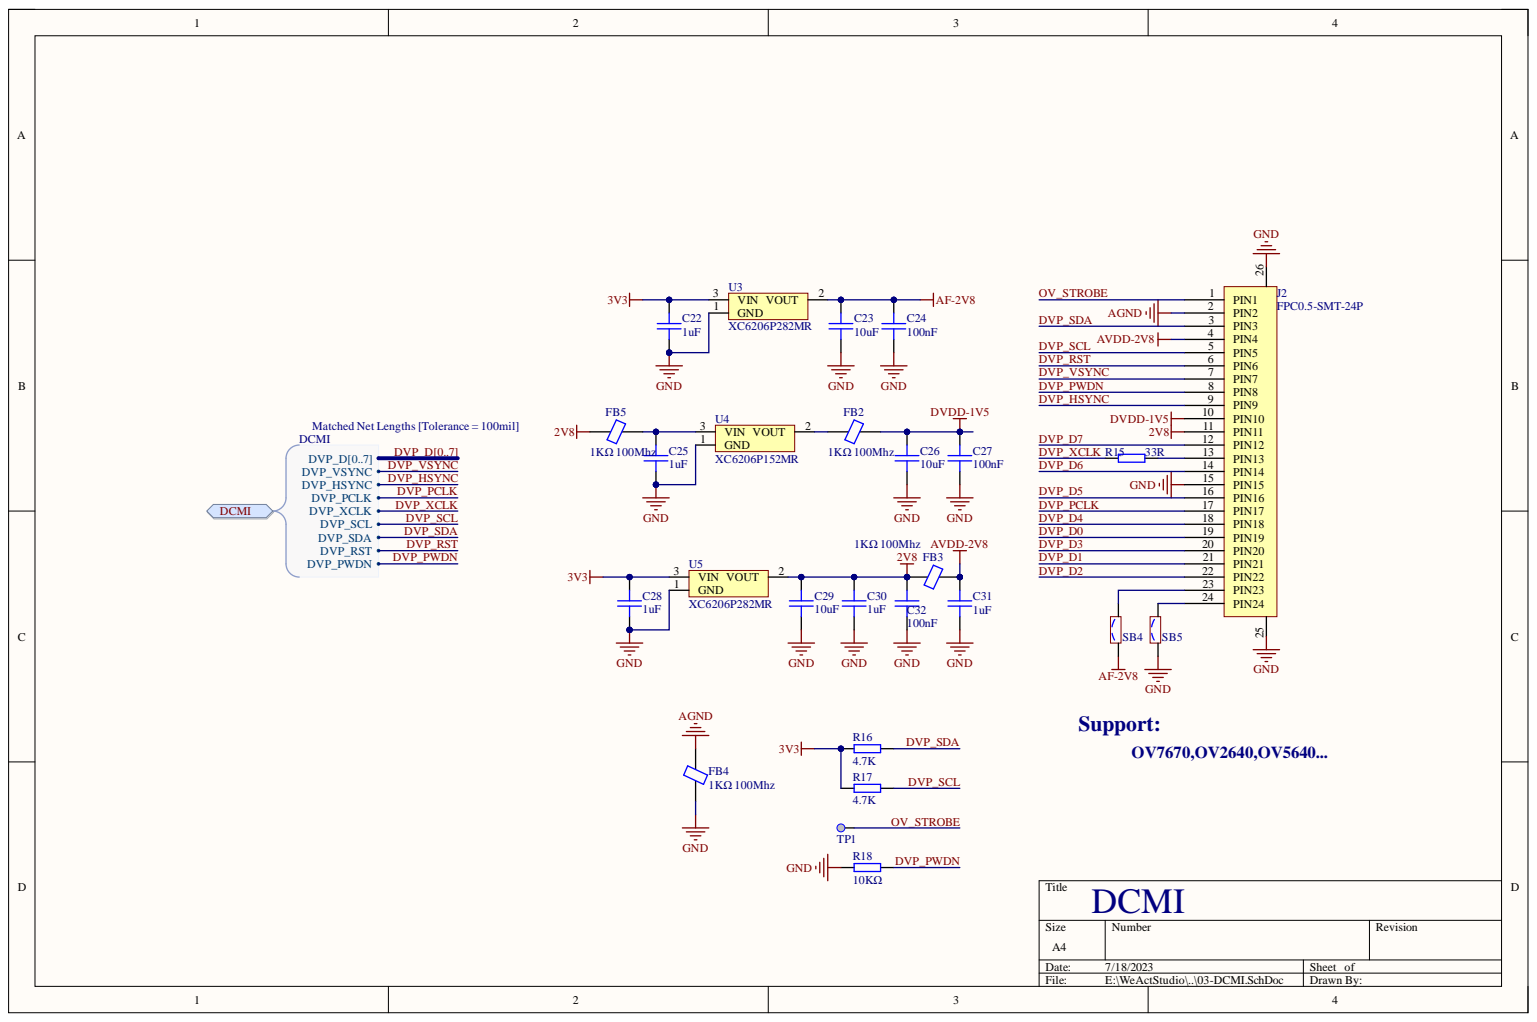
[picture p21: page 3]

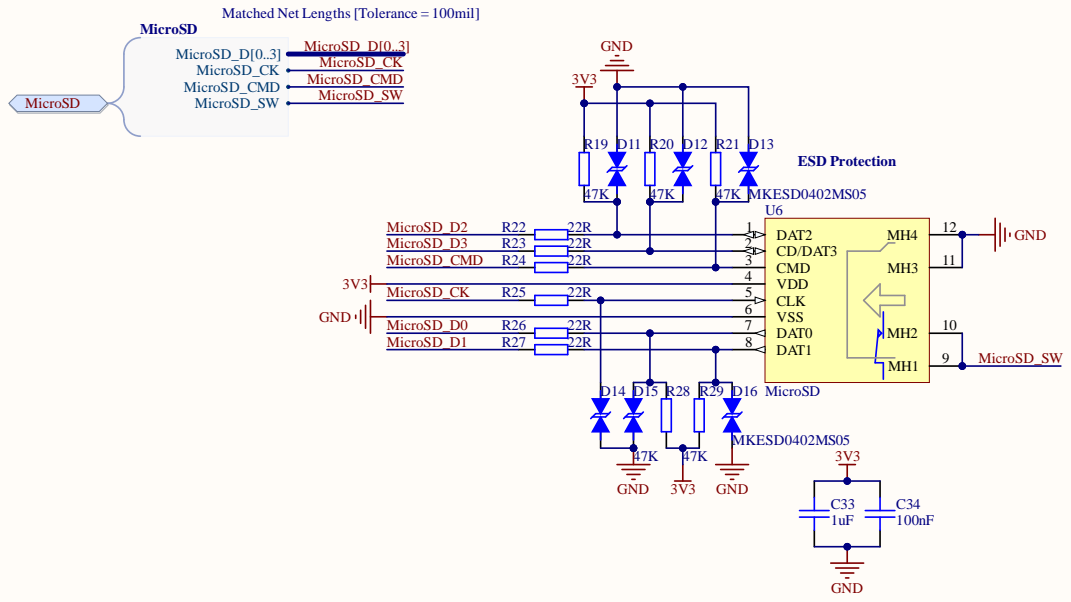
[picture p22: page 4]

2 | 1 1

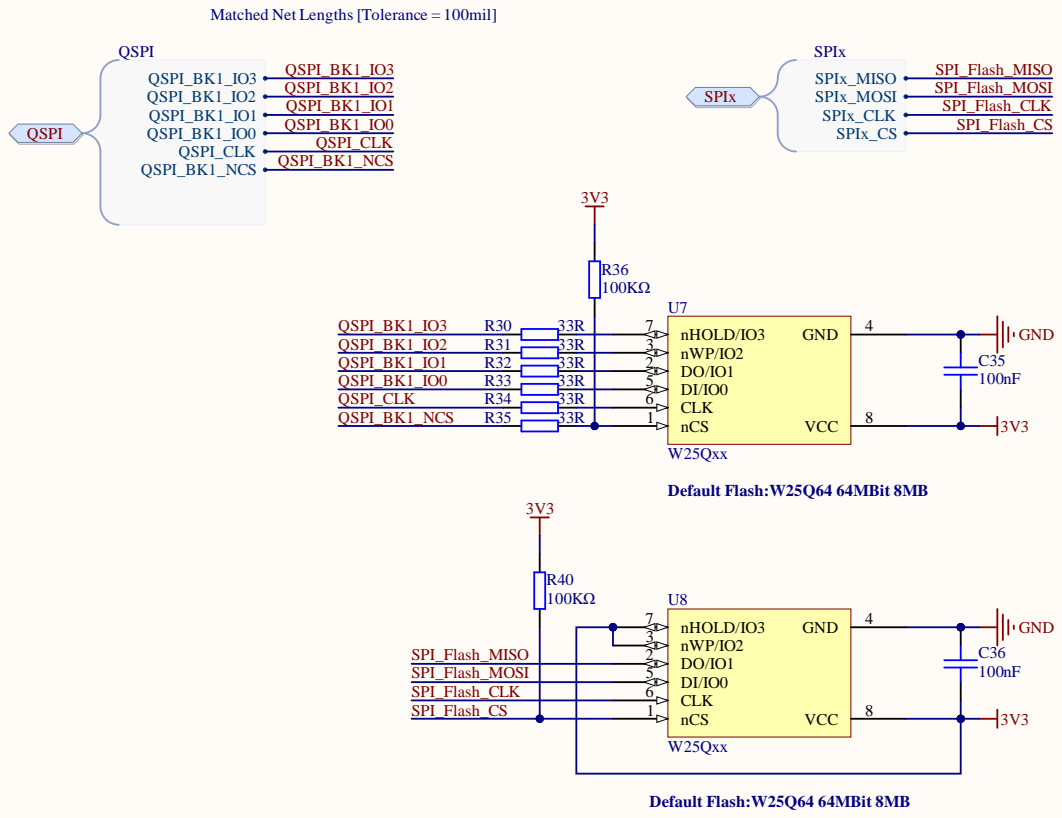
[picture p23: page 5]

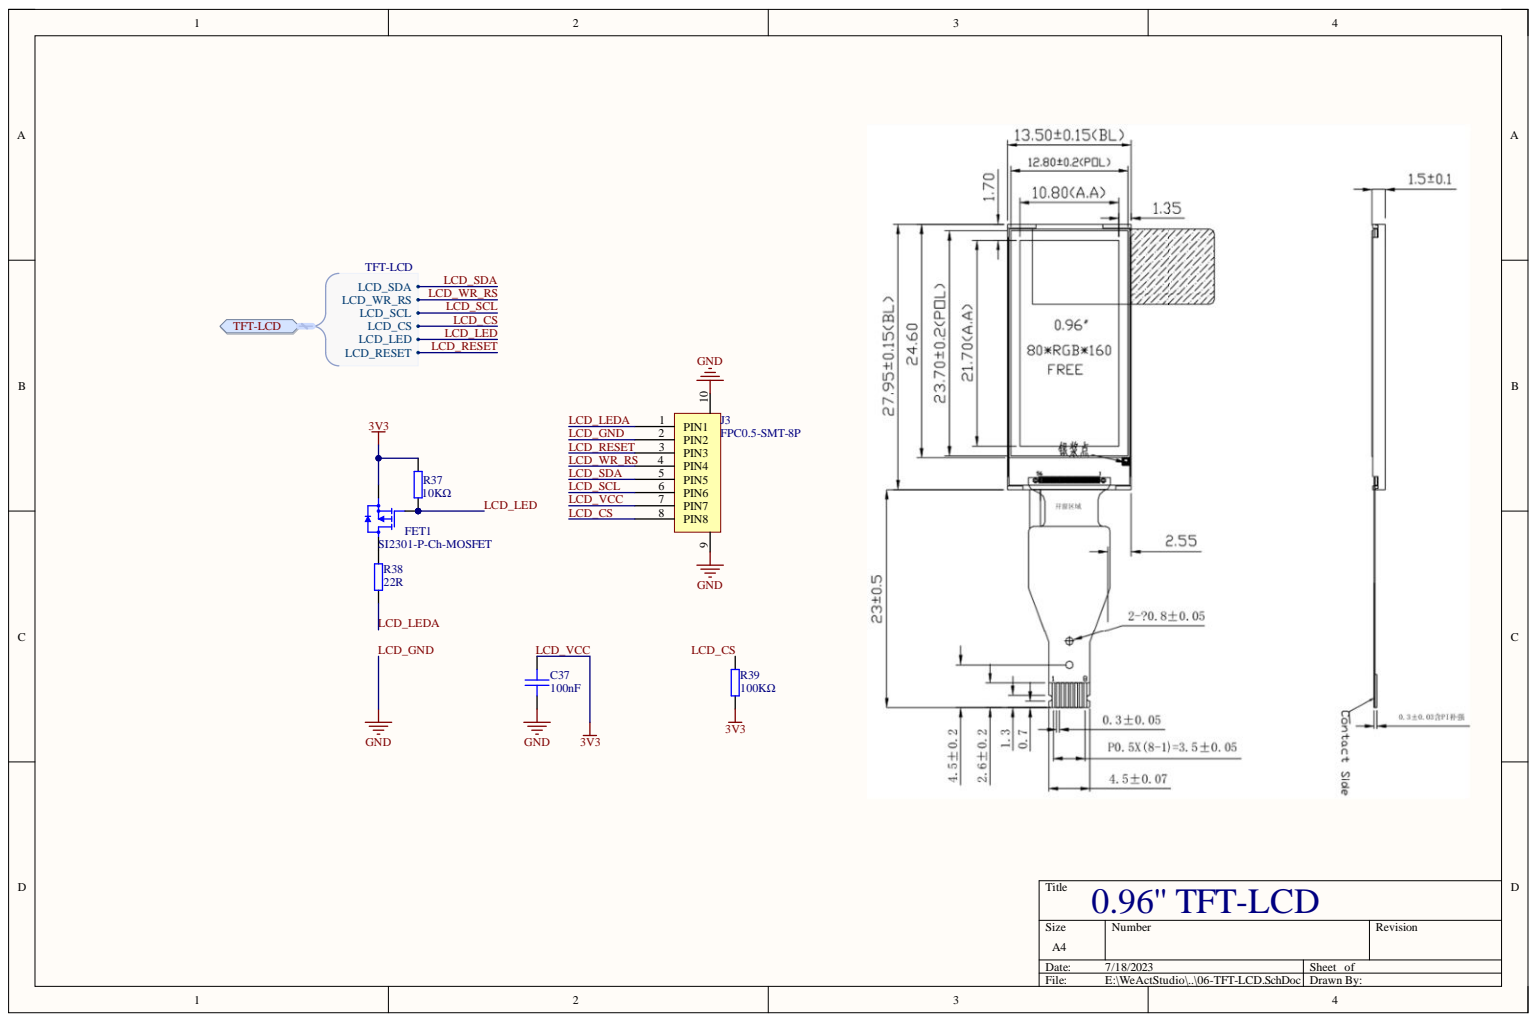
[picture p24: page 6]
