WeActStudio/MiniSTM32H7xx/Hardware/STM32H7xx_BoardShape Board Shape 外形 V12.pdf

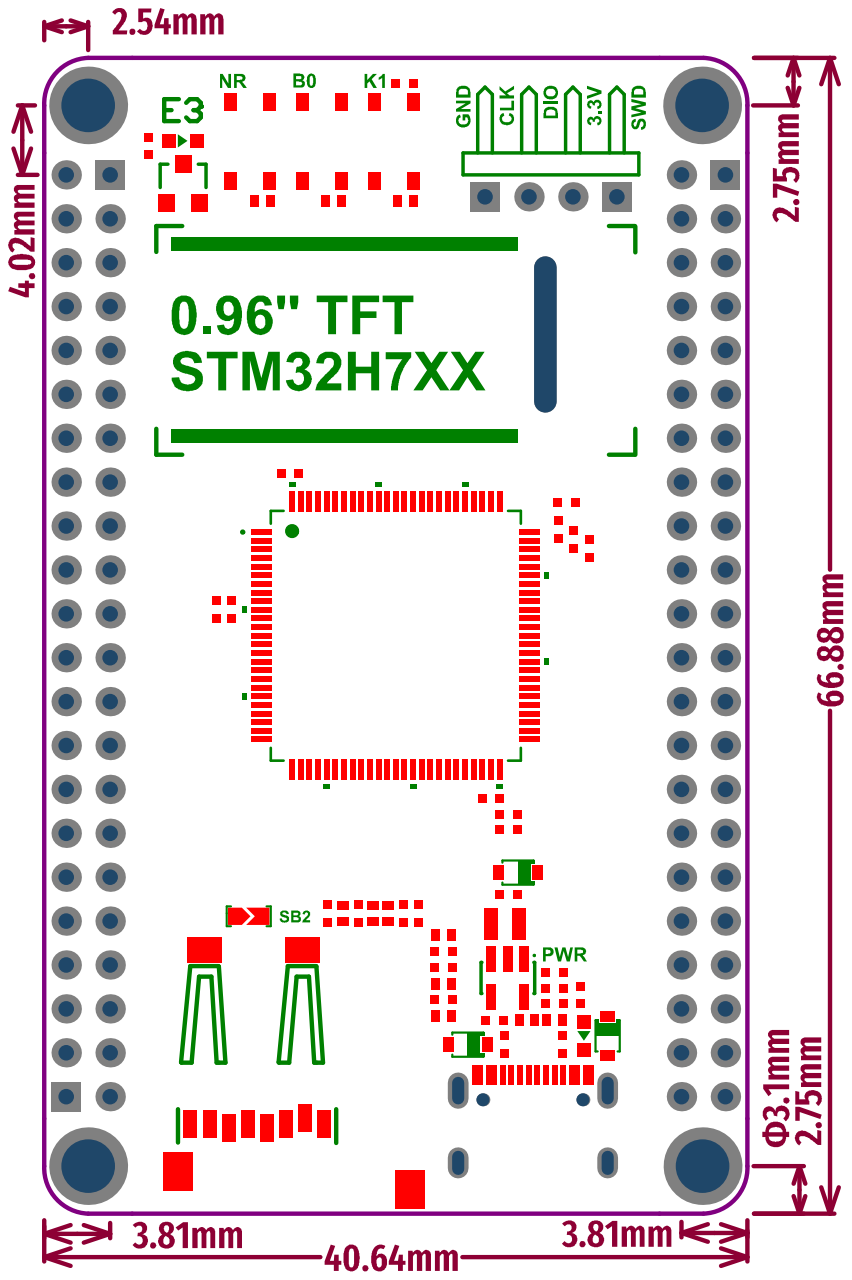
[picture p25: page 1]

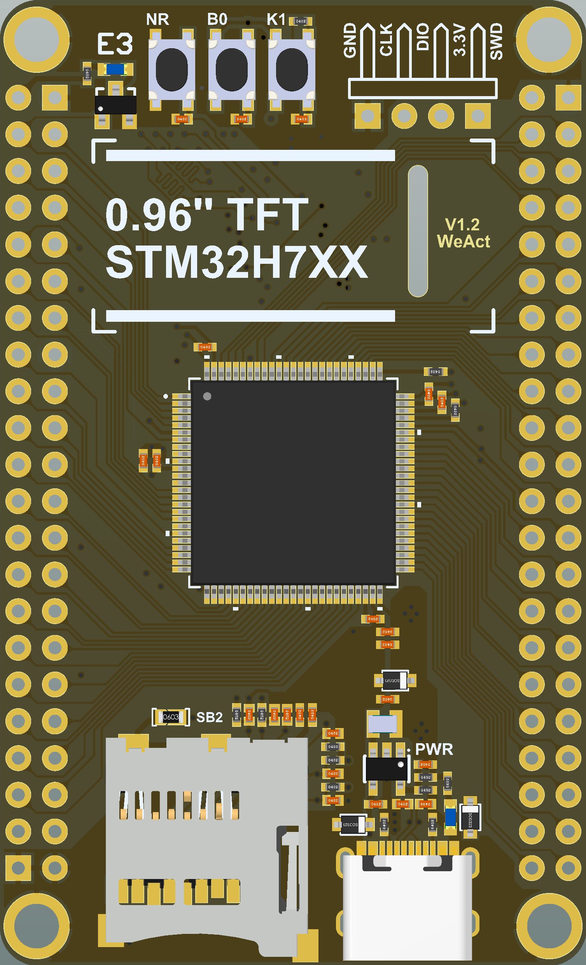
[picture p26: page 2]

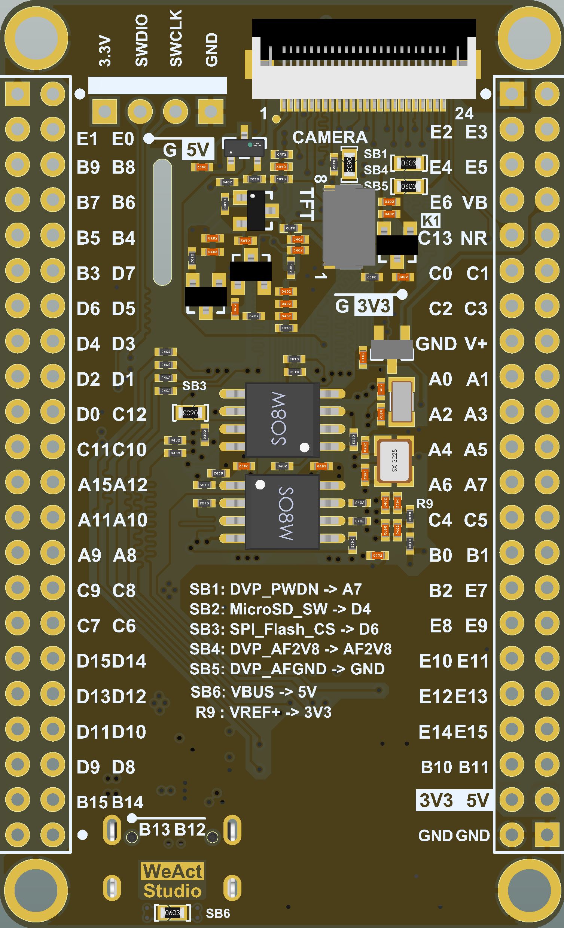
[picture p27: page 3]
