WeActStudio/MiniSTM32H7xx/Hardware/STM32H7xx_BoardShape Board Shape 外形.pdf

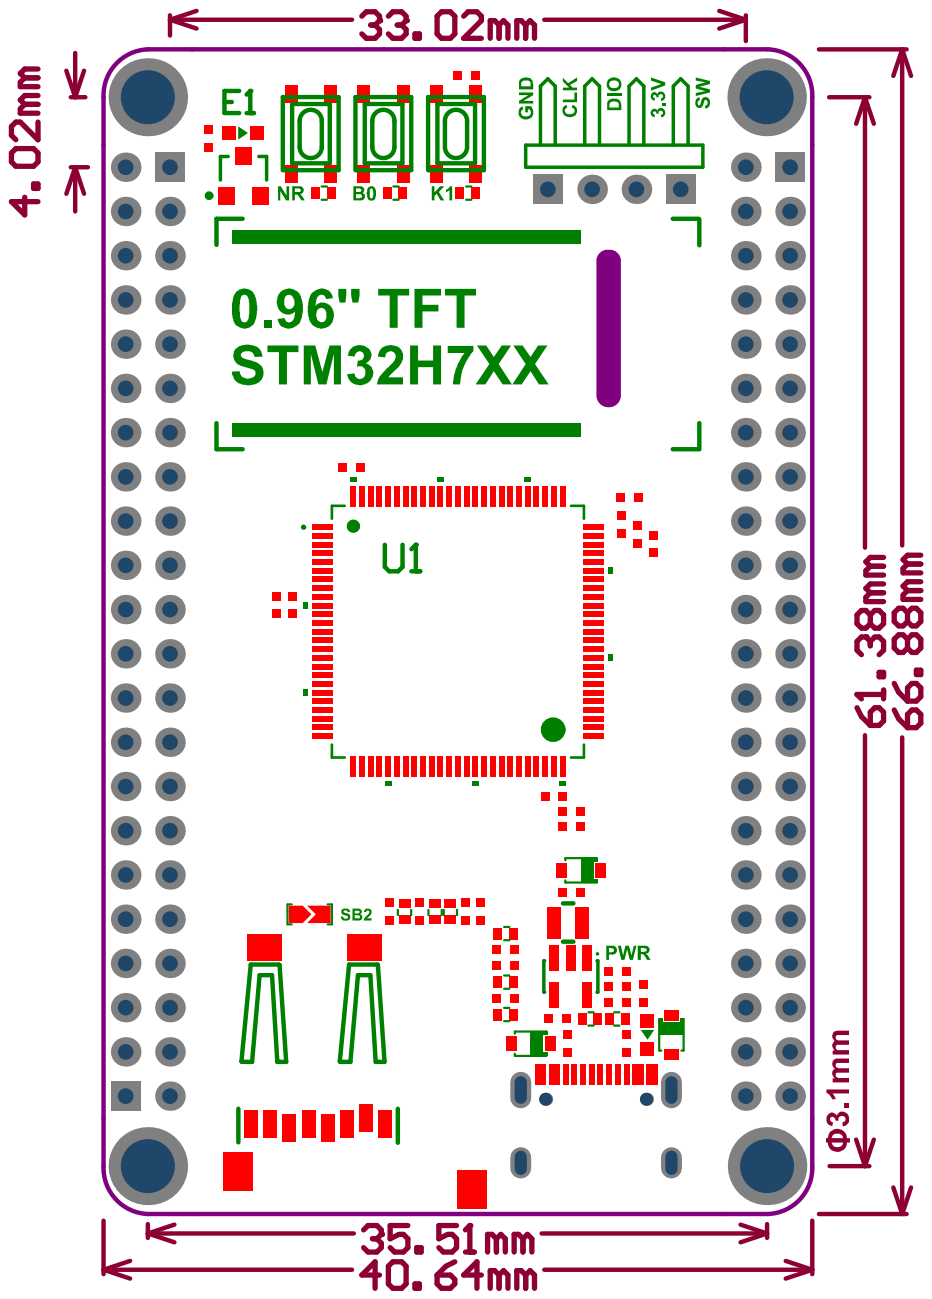
[picture p28: page 1]

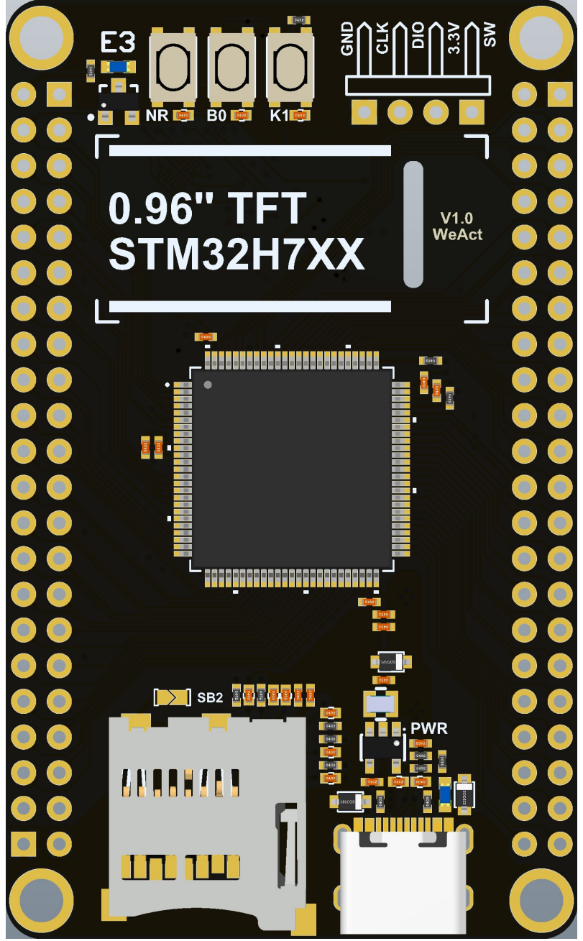
[picture p29: page 2]

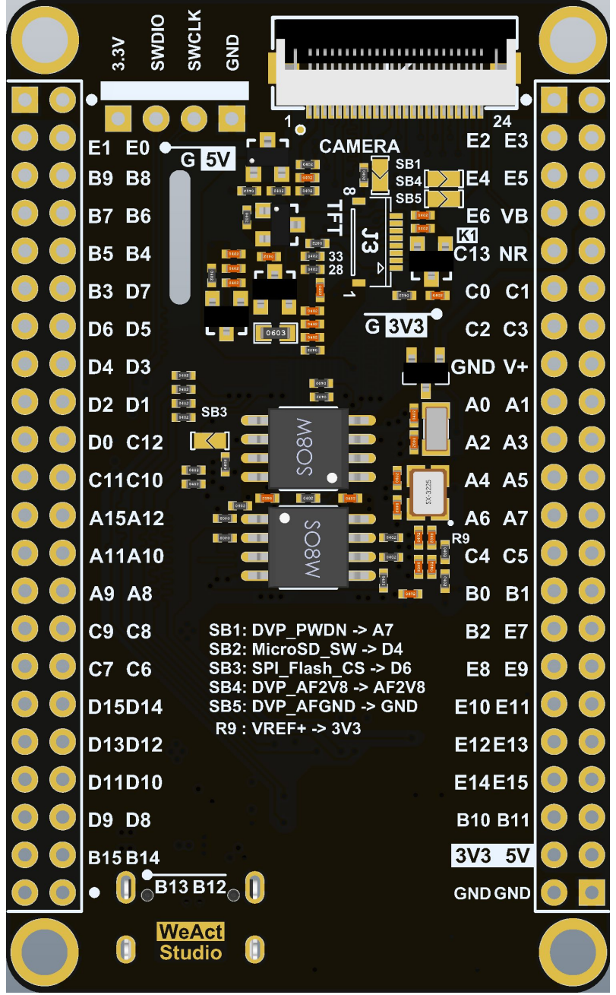
[picture p30: page 3]
