WeActStudio/MiniSTM32H7xx/Hardware/STM32H7xx SchDoc V11.pdf

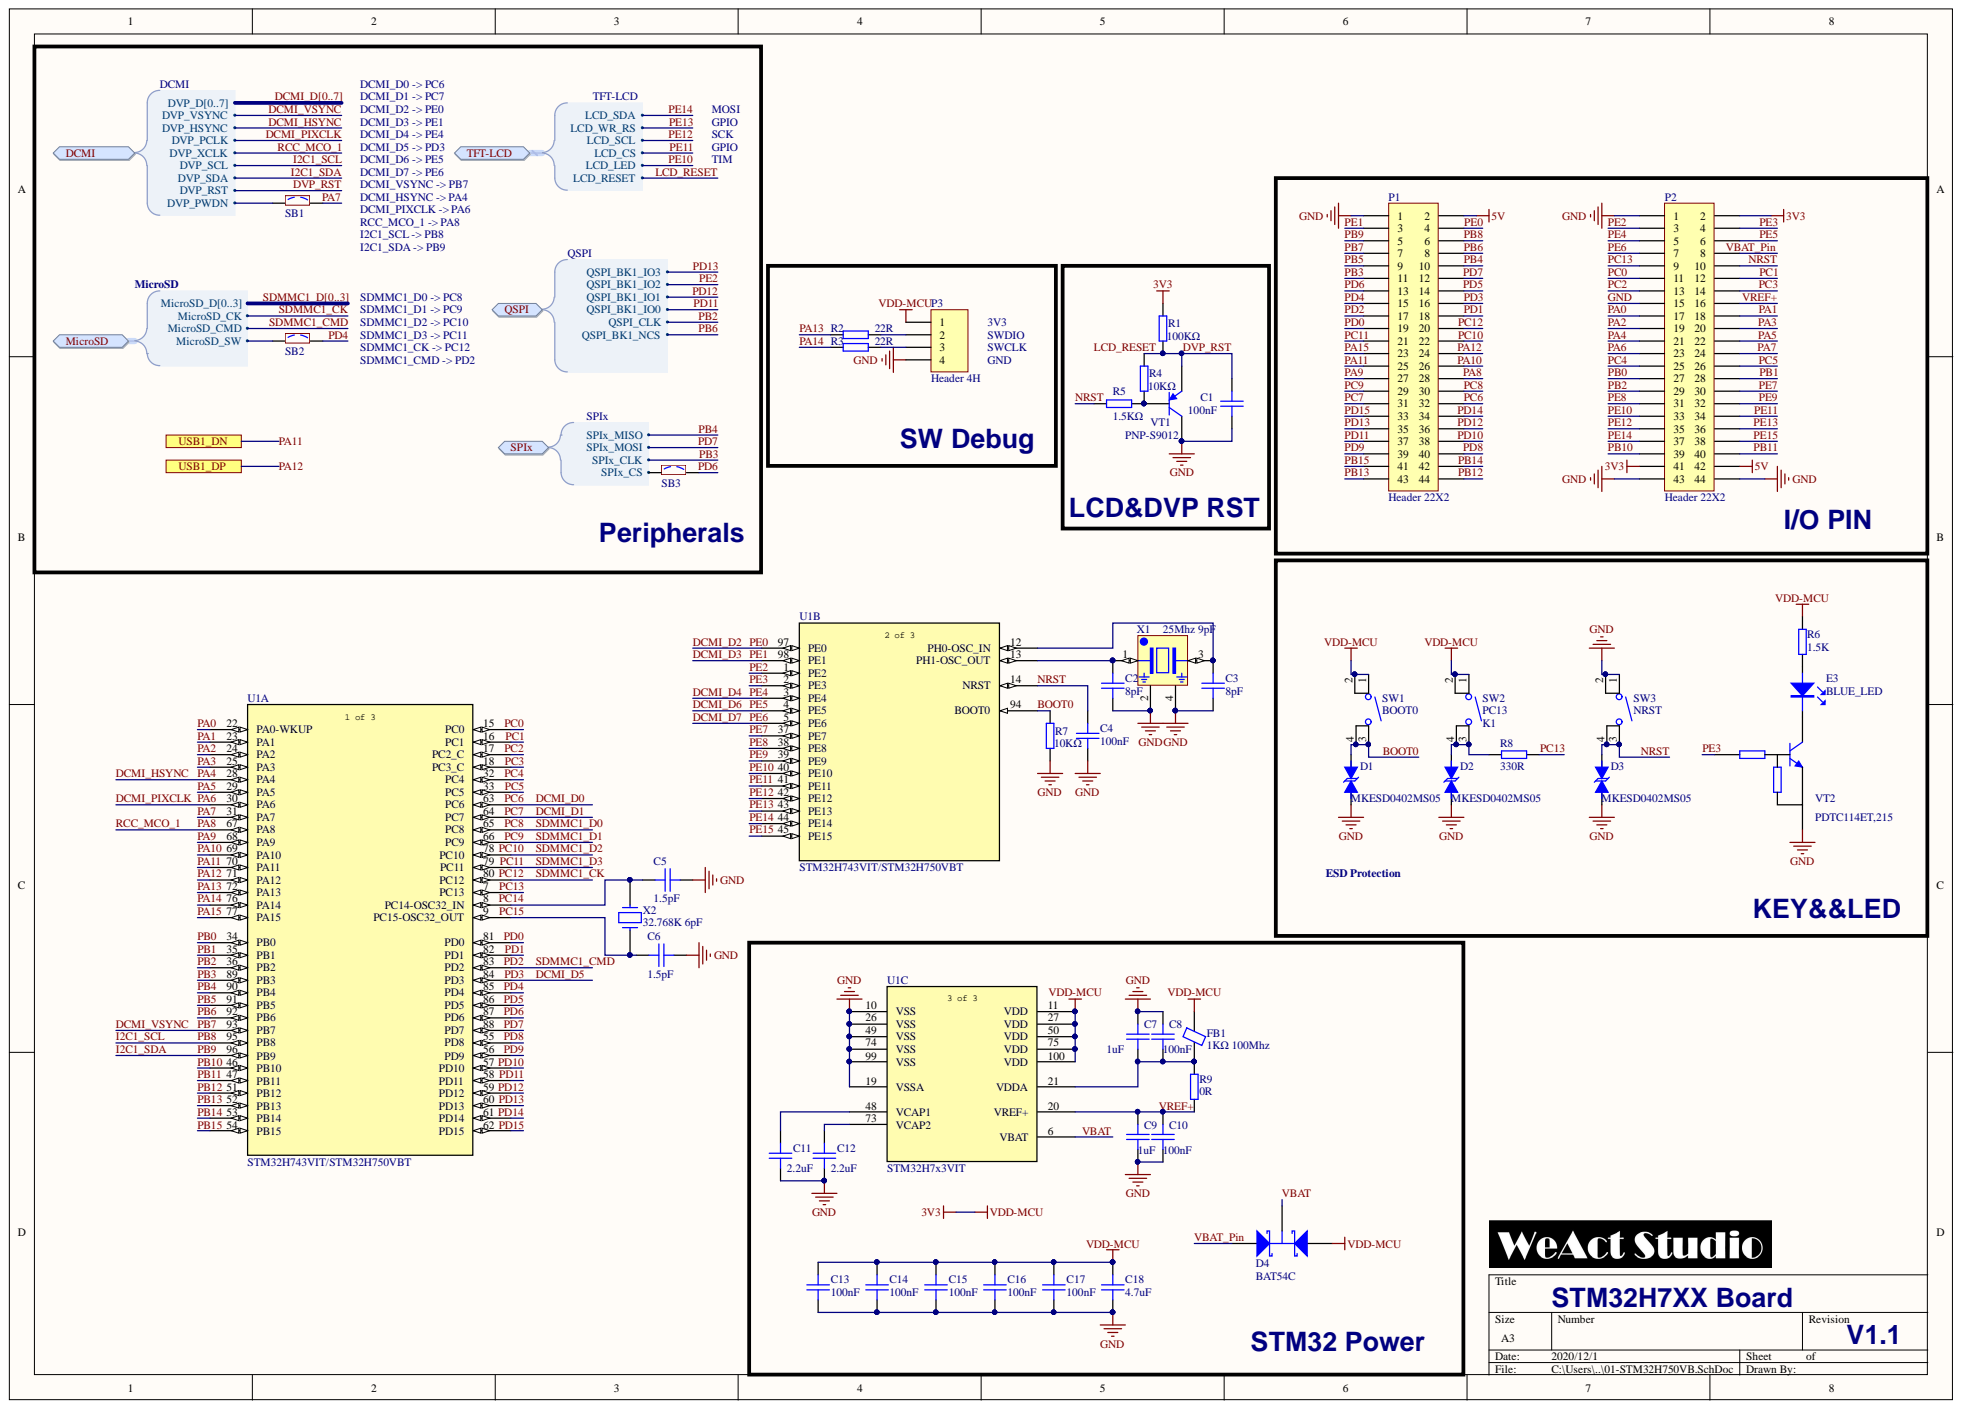
[picture p31: page 1]

PE2 1 | NRST

PE4 3 | | BOOT0

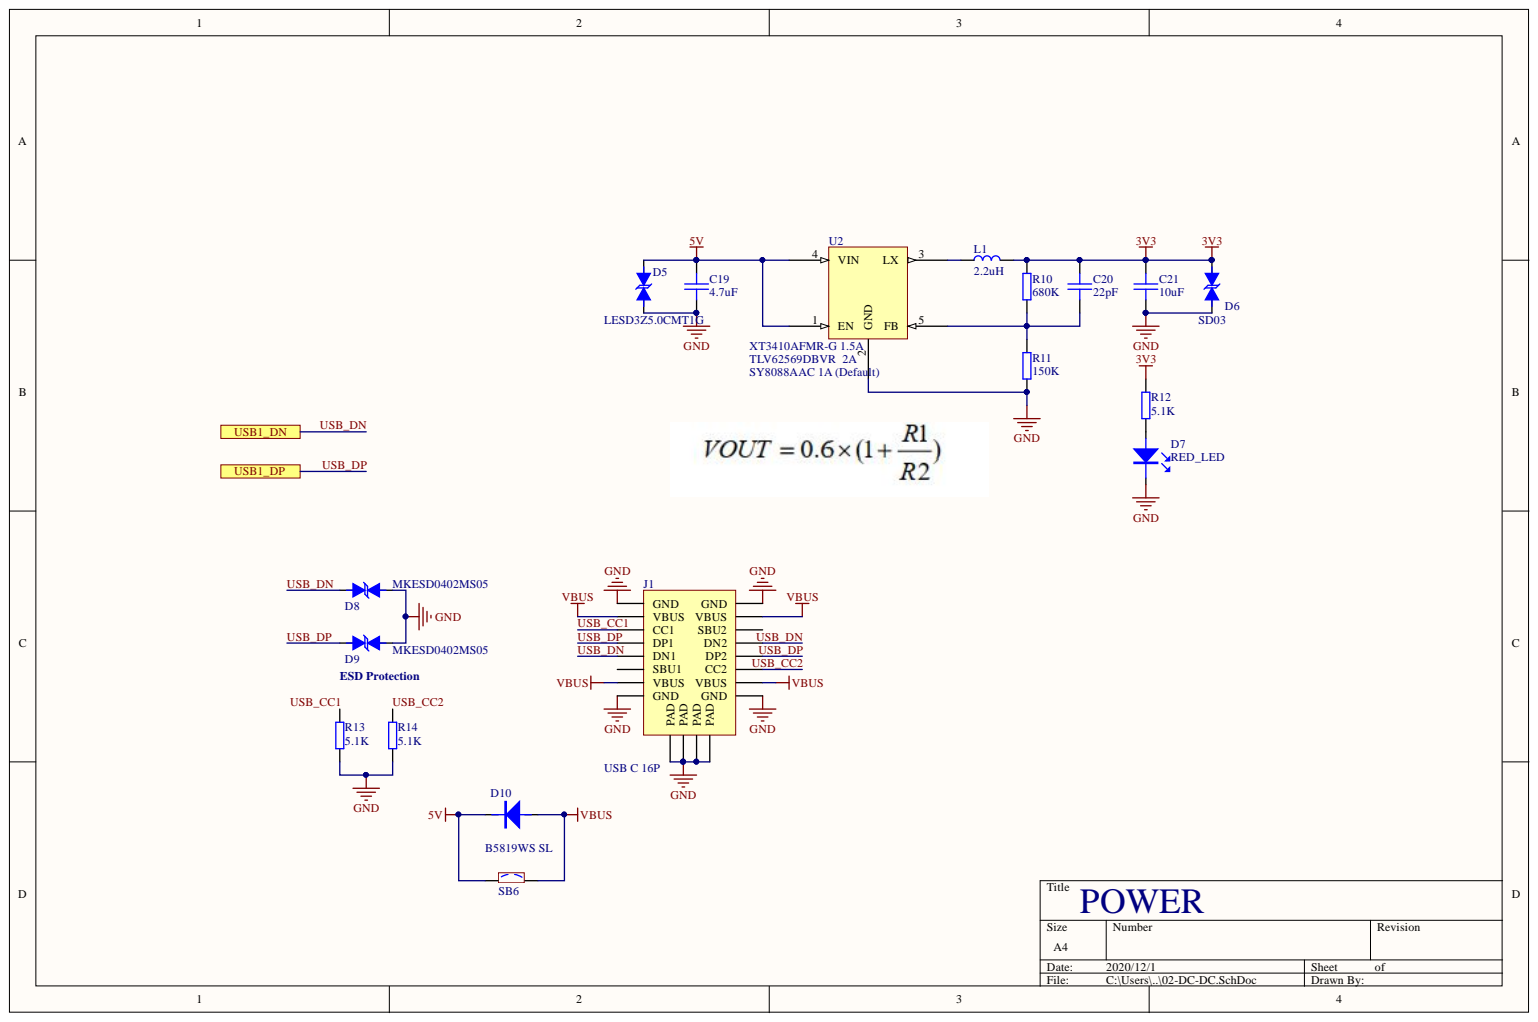
[picture p32: page 2]

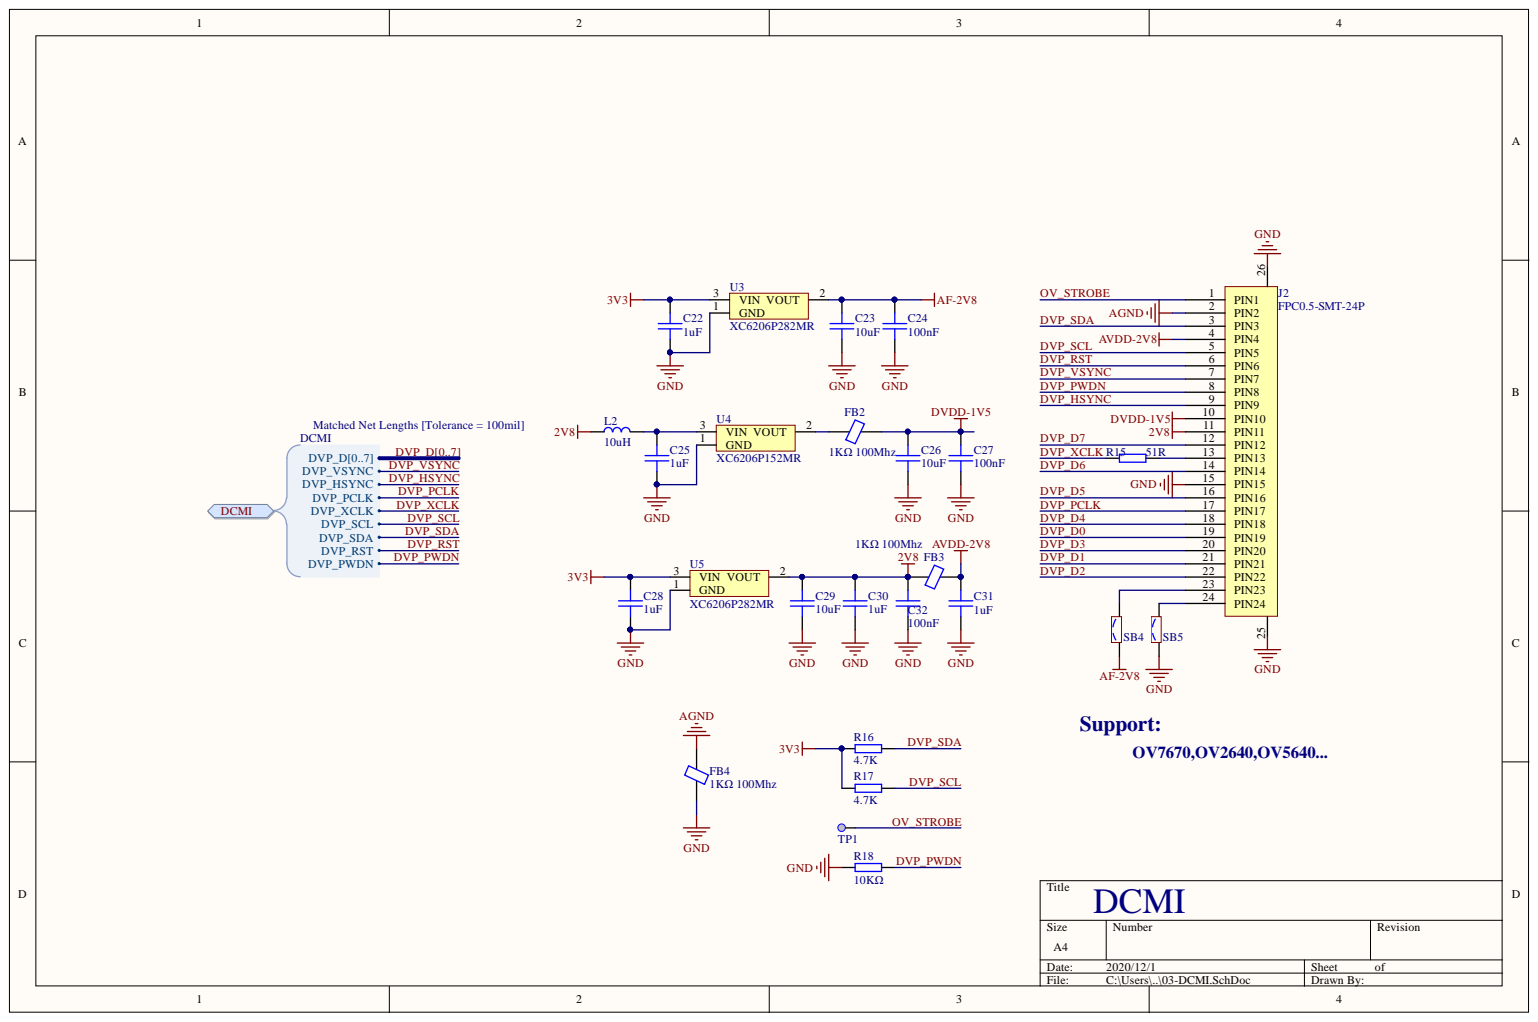
[picture p33: page 3]

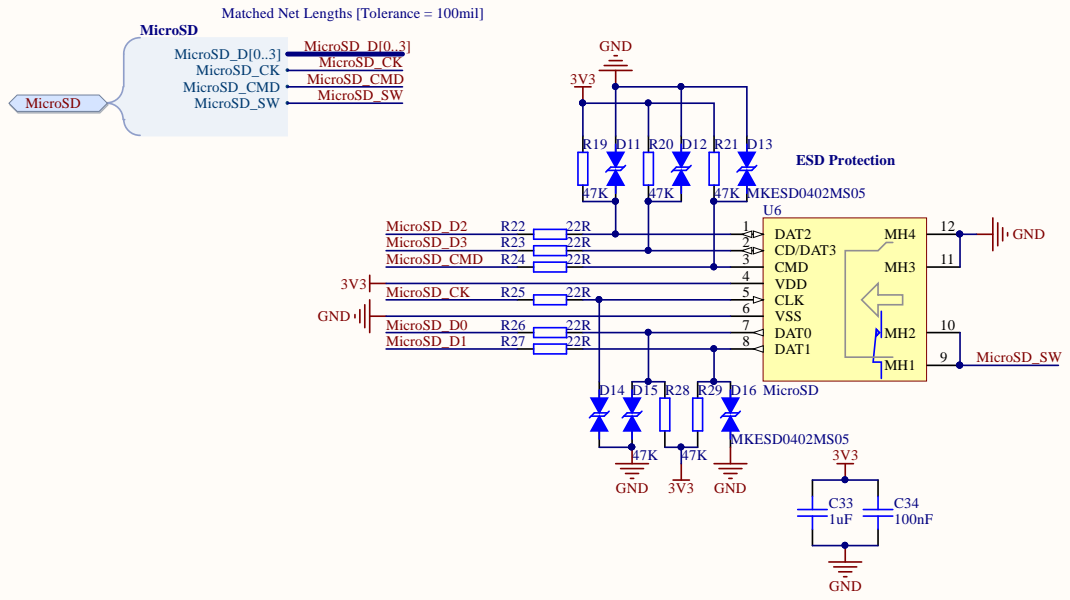
[picture p34: page 4]

2 | 1 1

8 | 9 | MicroSD _SW

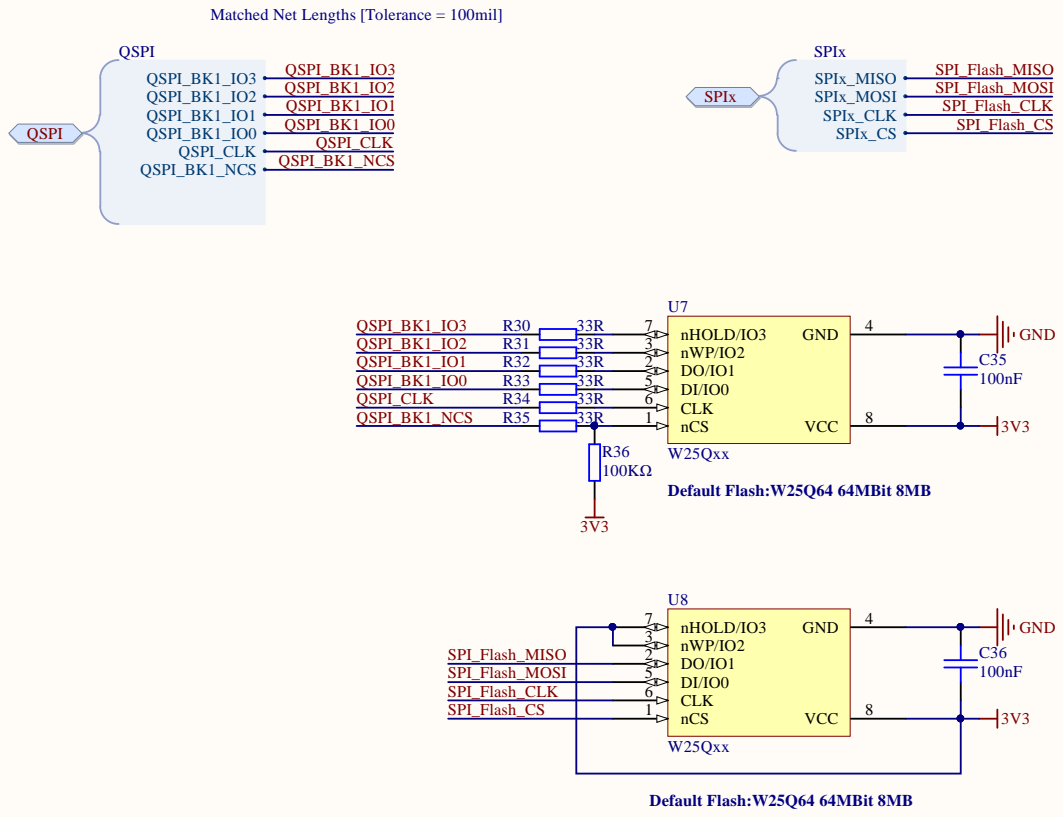
[picture p35: page 5]

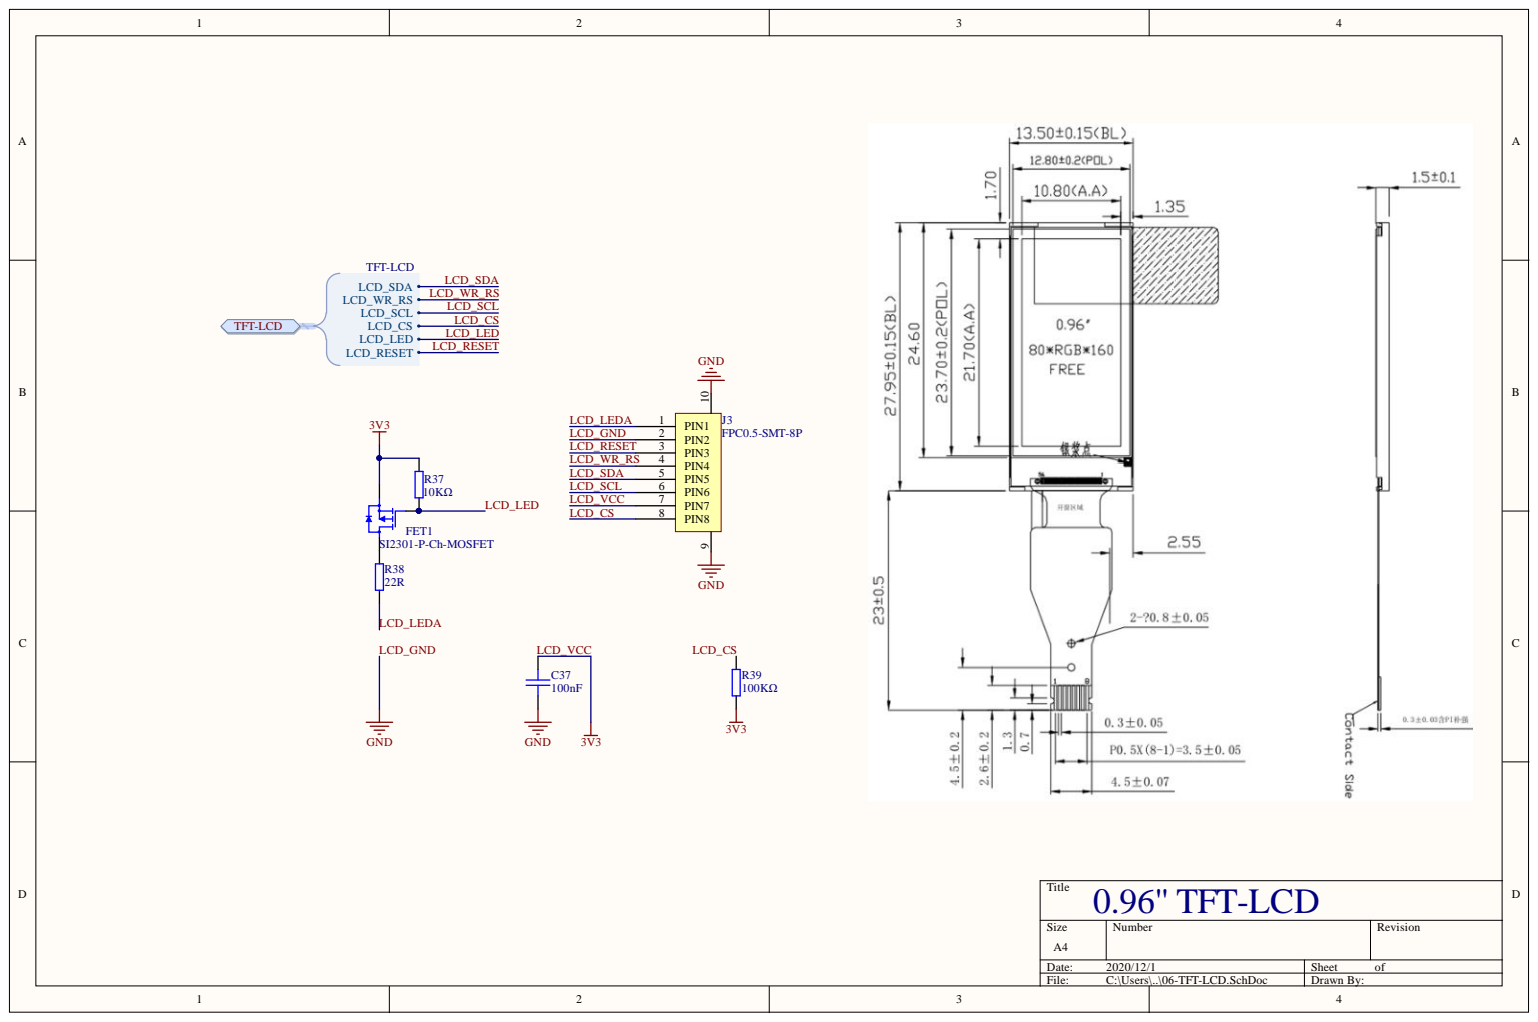
[picture p36: page 6]
