WeActStudio/MiniSTM32H7xx/Hardware/STM32H7xx SchDoc V10.pdf

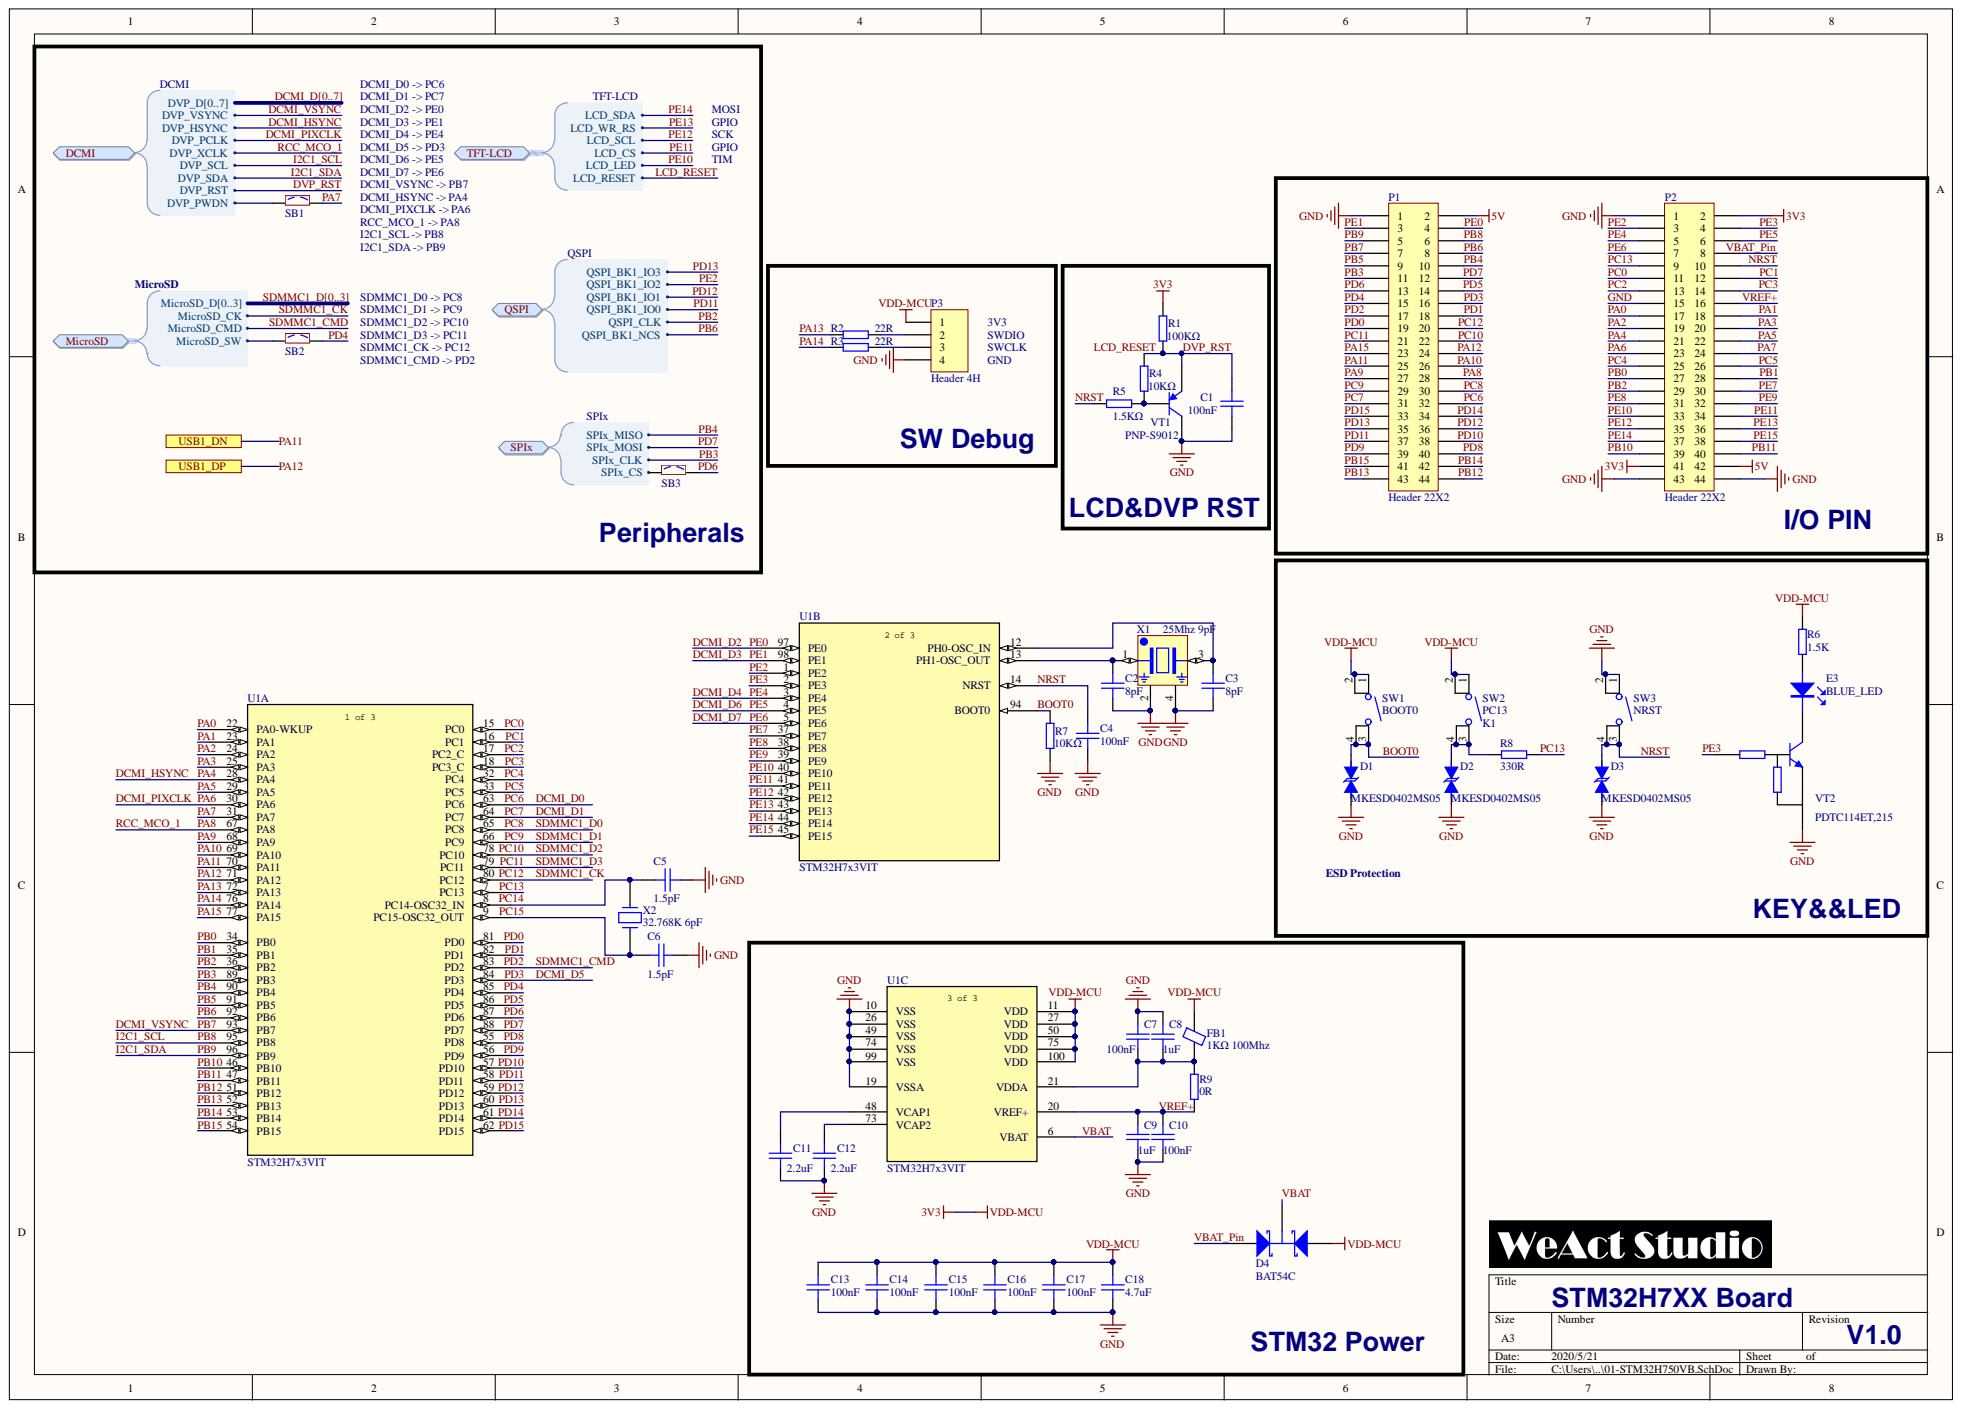
[picture p37: page 1]

PE2 1 | NRST

PE4 3 | | BOOT0

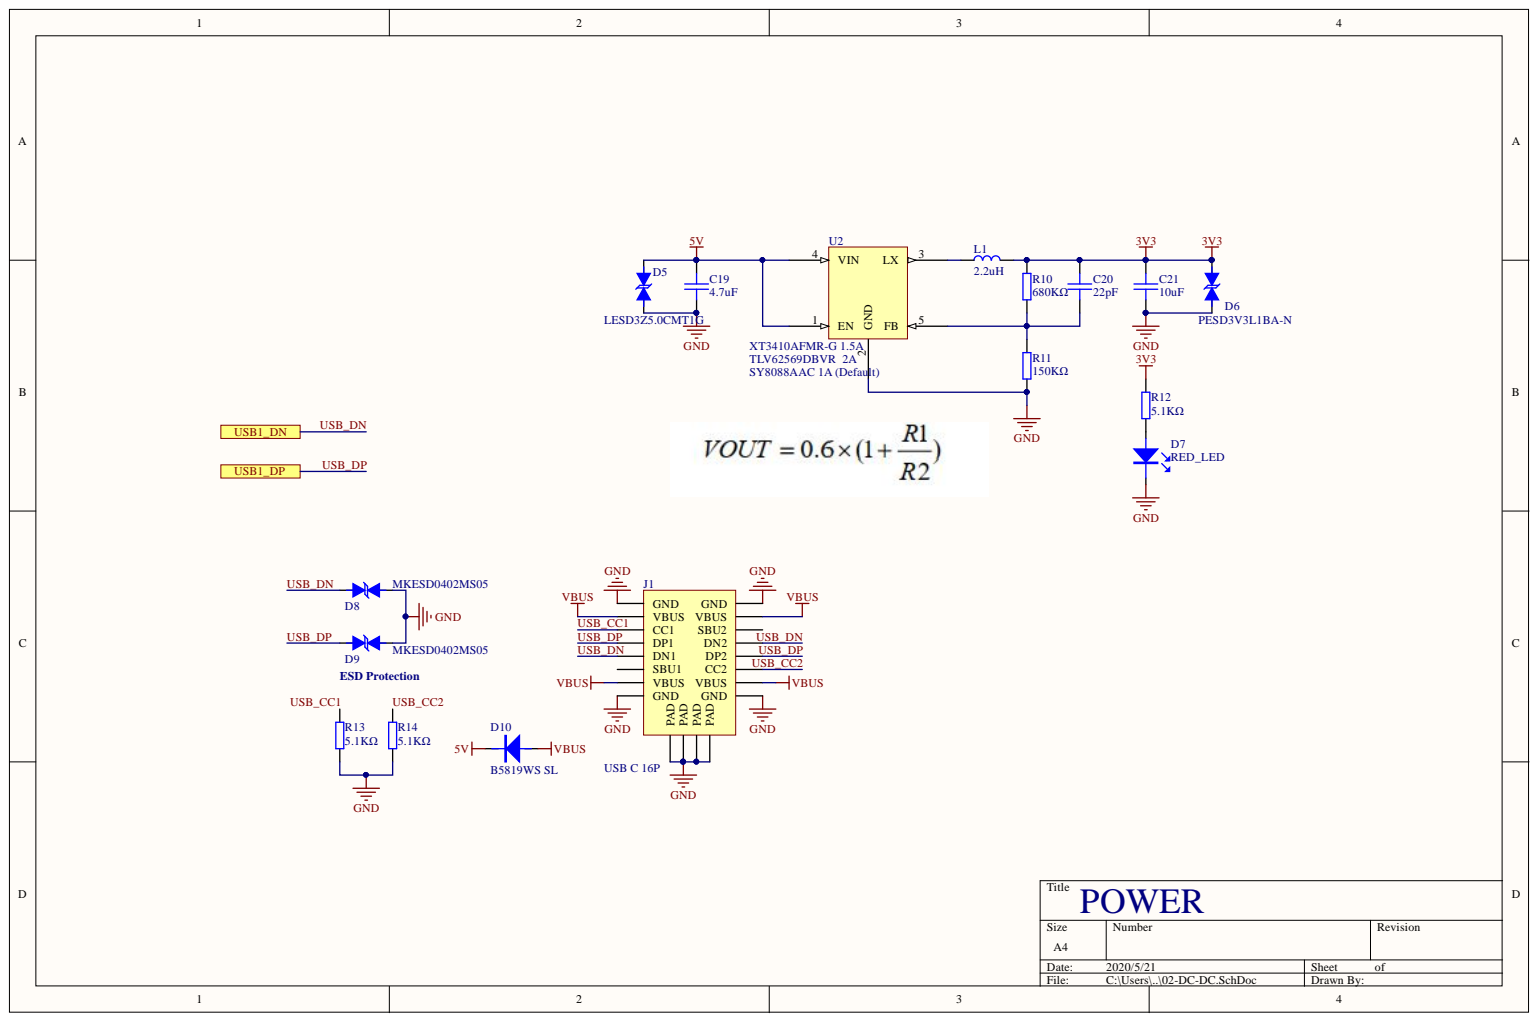
[picture p38: page 2]

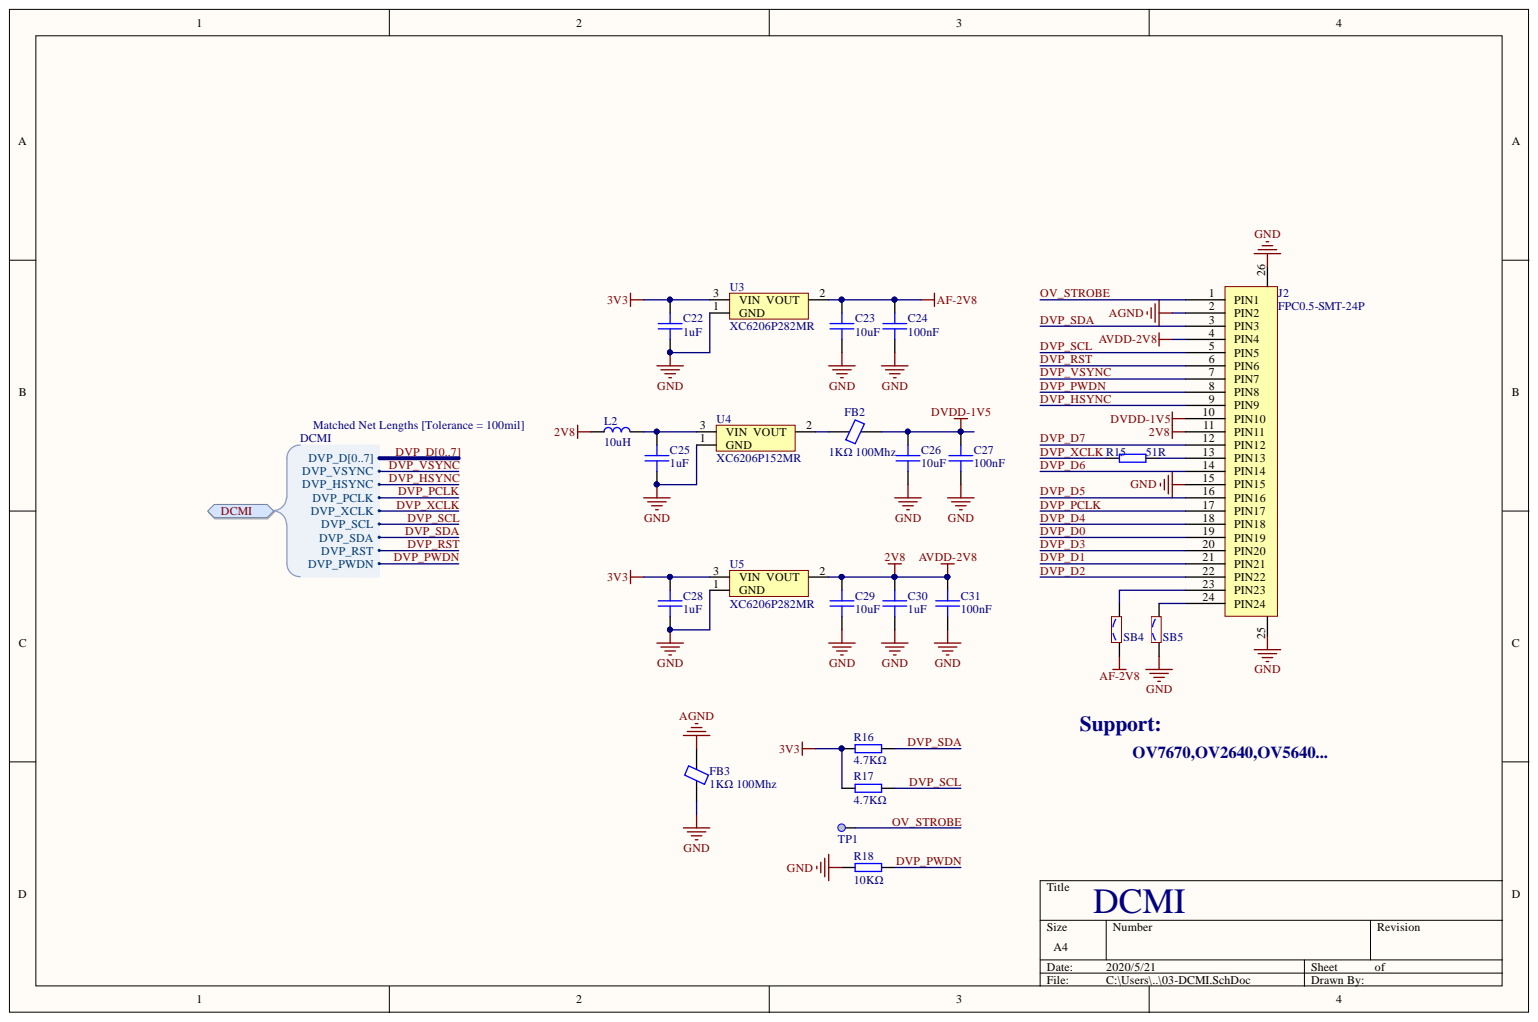
[picture p39: page 3]

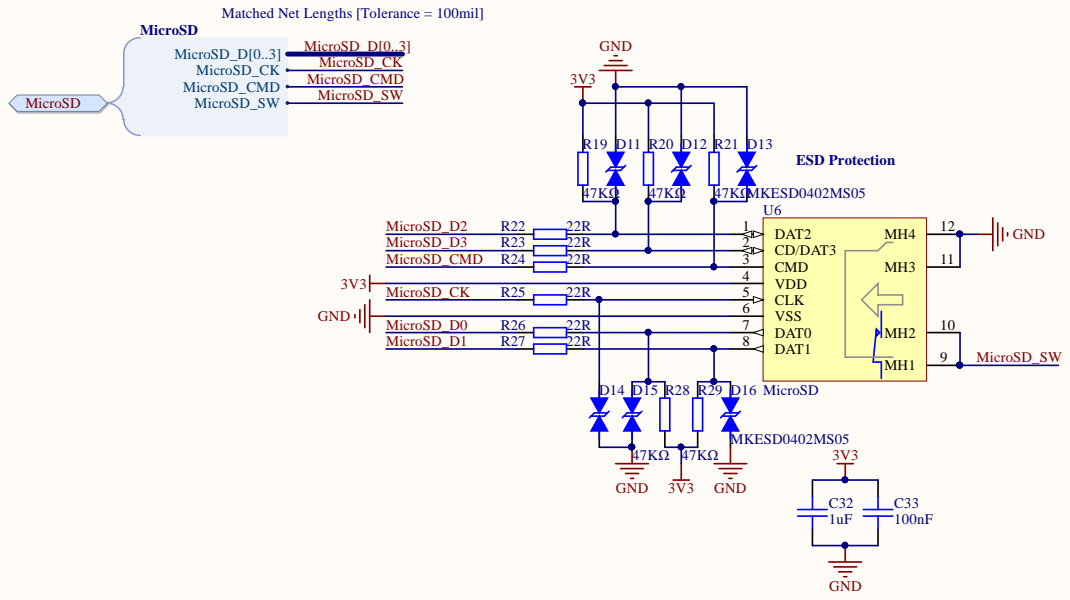
[picture p40: page 4]

2 | 1 1

8 | 9 | MicroSD _SW

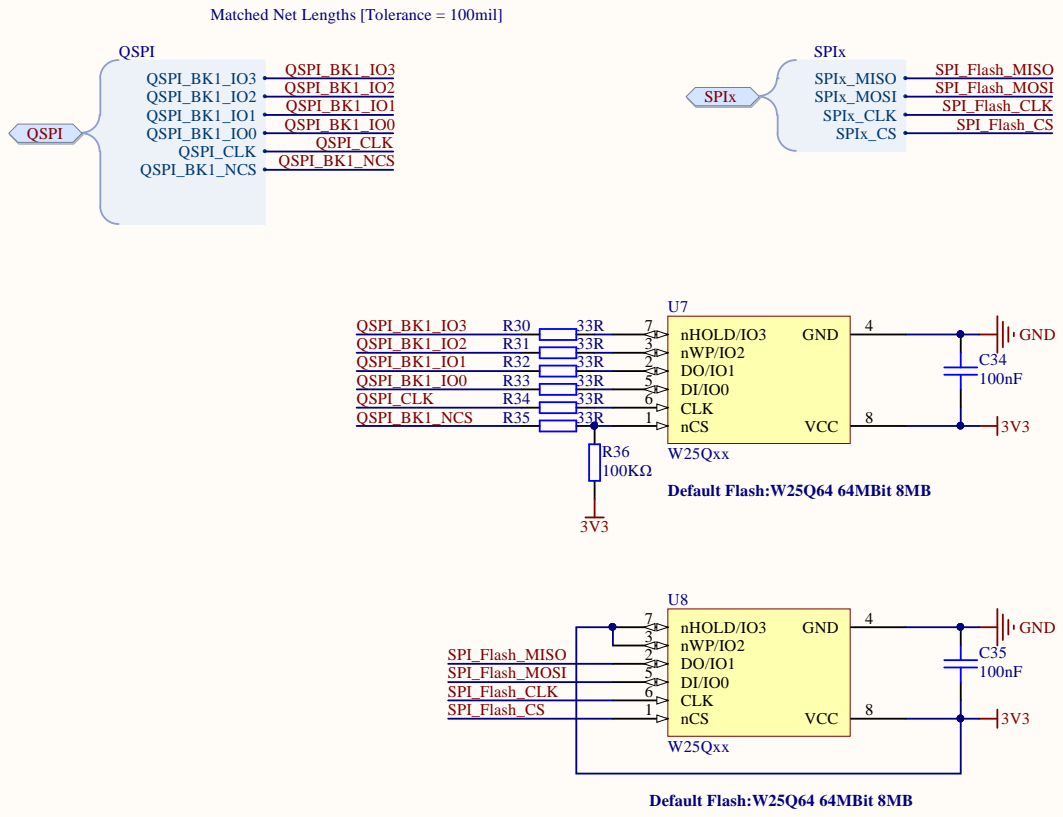
[picture p41: page 5]

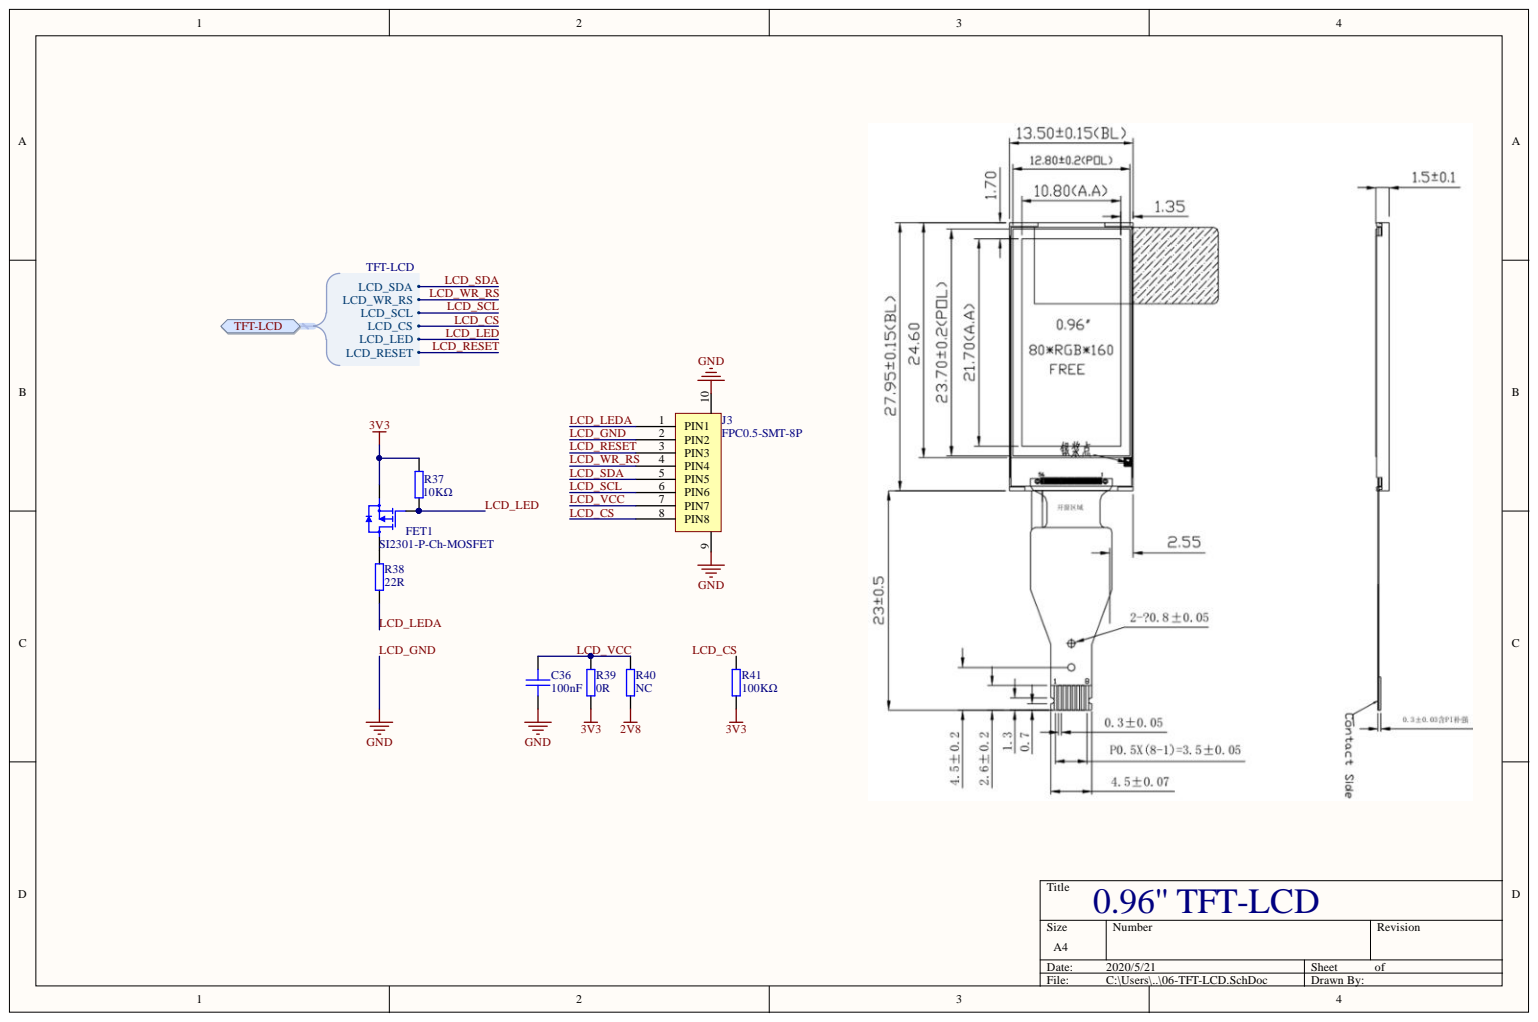
[picture p42: page 6]

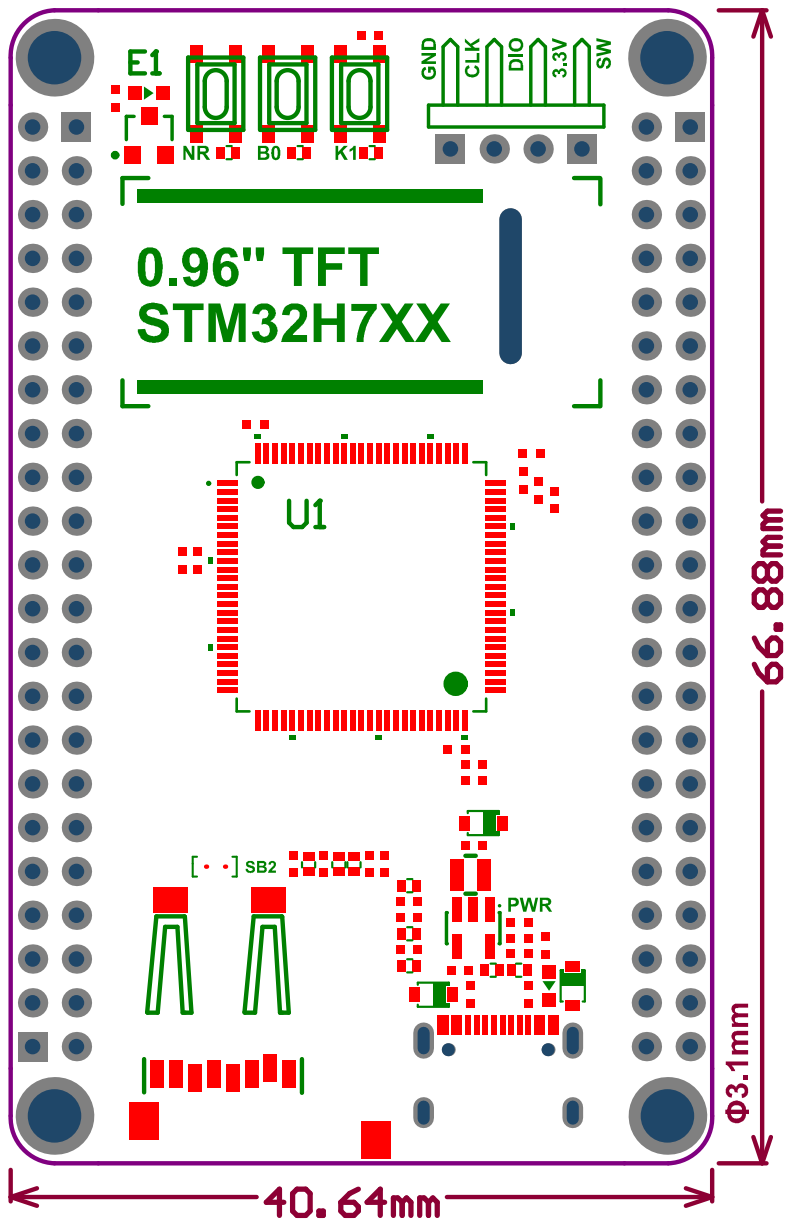
[picture p43: page 7]
