WeActStudio/MiniSTM32H7xx/(commit log)

2020-05-24 Add openmv support
    [pins.csv]
2020-05-27 Modify the openmv configuration file
    [pins.csv]
2020-06-05 Fix WeAct Studio USB Download Tool DFU Driver
2020-06-19 Update HAL LCD Driver && Add ov7725 support
2020-06-20 Add SPI Flash Erase Firmware for openmv
2020-07-10 Add some datasheet&&Update SDK - Renamed datasheet - SDK/HAL/08-DCMI2LCD Add OV5640 Support - Add HDK/STM32H750VB CoreBoard WeAct Studio.step
2020-08-13 schematic correct the mistake
2020-09-21 Add support for 1.8-inch screen -modify some functions of camera
2020-09-21 Add support for 1.8-inch screen modify some functions of camera
2020-10-31 Add STM32H743VI Core Board
2021-10-05 Update STM32H750 03-LCD_Test,06-SPIFlash_Test,07-ADC_Test Example
2021-10-05 Update STM32H750 08-DCMI2LCD Example zhuyix@zhuyix-PC:/data/home/zhuyix/WeActStudio/openmv$ git status
2021-10-05 Update STM32H750 11-ExtMem_Boot_USB Example
2021-10-06 Update STM32H743 11-ExtMem_Boot_USB Example
2021-10-06 Update STM32H743 07-ADC_Test Example
2021-10-06 Update STM32H743 06-SPIFlash_Test Example
2021-10-06 Update STM32H750 03-LCD_Test Example
2021-10-06 Update STM32H743 03-LCD_Test Example
2022-04-04 update stm32h750 01-GPIO,02-ExtMem_Boot HAL Example
2023-03-19 update stm32h750 hal example
2023-04-09 update STM32H7xx Board Shape
2023-06-28 update stm32h750 01-gpio examples
2023-06-29 update stm32h750 03-LCD_Test examples
2023-07-02 update stm32h750 04-SD_Test examples
2023-07-02 update stm32h750 07-ADC_Test examples
2025-06-30 ADC_Test: Fix for BSP lcd module
    See e.g. the same file in 03-LCD_Test/Drivers/BSP/ST7735/lcd.c
2025-12-19 add OV7725-Camera Board Shape and rename HDK to Hardware
2026-02-15 1. Update the OpenMV firmware and the routines. 2. Adjust the directory structure and move the old versions to a single folder.
    [pins.csv]
2026-03-04 add OV7725-M12-Camera SchDoc
2026-11-03 docs: point blog links to new post routes
    The blog migrated to a static site: /YYYY/MM/DD/slug/ became /posts/slug/.
    - STM32Download -> posts/stm32-download-tutorial
    - micropython -> posts/stm32f411ce-micropython-tutorial
    - WeAct-LogicAnalyzerV1 -> posts/pulseview-use-tutorial
    - fx2lafw driver zip is not on the new site, keep the old host
